bdevijve/STM32F1_28Outputs/README.md

# STM32F1_28Outputs
Carte domotique de Gaël - STM32F103VET6 - 28 sorties NPN 5-24V
