bdevijve/STM32F1_28Outputs/HW/Ressources/étiquette.pdf

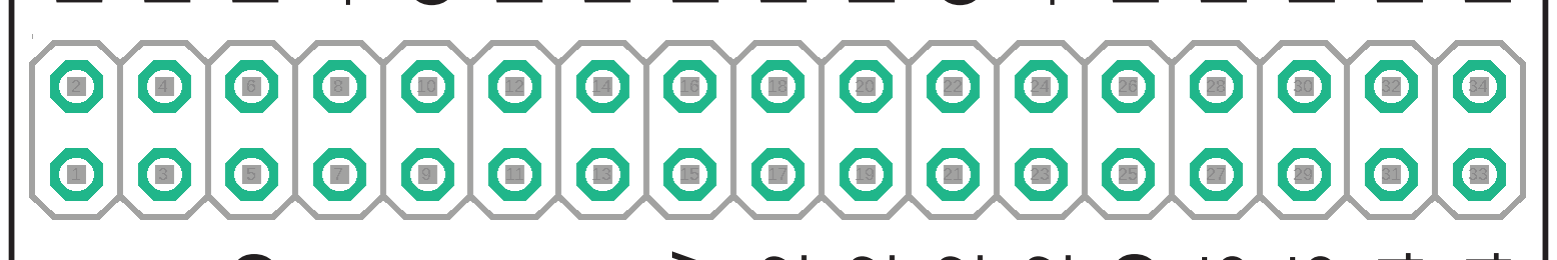
[picture p1: figure]

1 | 2 | 3 | 4 | 5 | 6 | 7 | 8 | 9 | 10 11 12 13 14 15 16 17 18 19 20 21 22 23 24 25 26 27 28

## COMMUN +

## 28 SORTIES PNP - COMMUTATION PAR LE (-)

GND | + | ETHERNET

## Alimentation: 5V - 24V DC Maximum 5A

# MODULE DE PILOTAGE DE RELAIS - 28 SORTIES

BOOT0

PB7 - SDA1
PB6 - SCL1

+3.3V
GND

PD7 - CK2
PD5 - RX2
PD6 - TX2

PD4 - RTS2

PD3 - CTS2

GND

+3.3V

PA8 - CK1
PA9 - RX1

PA10 - TX1

PA12 - RTS1

PA11 - CTS1

BP2 -BOOT1

PD5 - SMBA1
GND

PA4 - NSS1

PA5 - SCK1
PA7 - MOSI1

PA6 - MISO1

+3.3V
PB12 - NSS2
PB13 - SCK2

PB15 - MOSI2

PB14 - MISO2
GND

PC12 - RX5

PD2 - TX5

PC10 - RX4

PC11 - TX4

## STM32F103VET6
