bdevijve/STM32F1_28Outputs/HW/Image 1.png

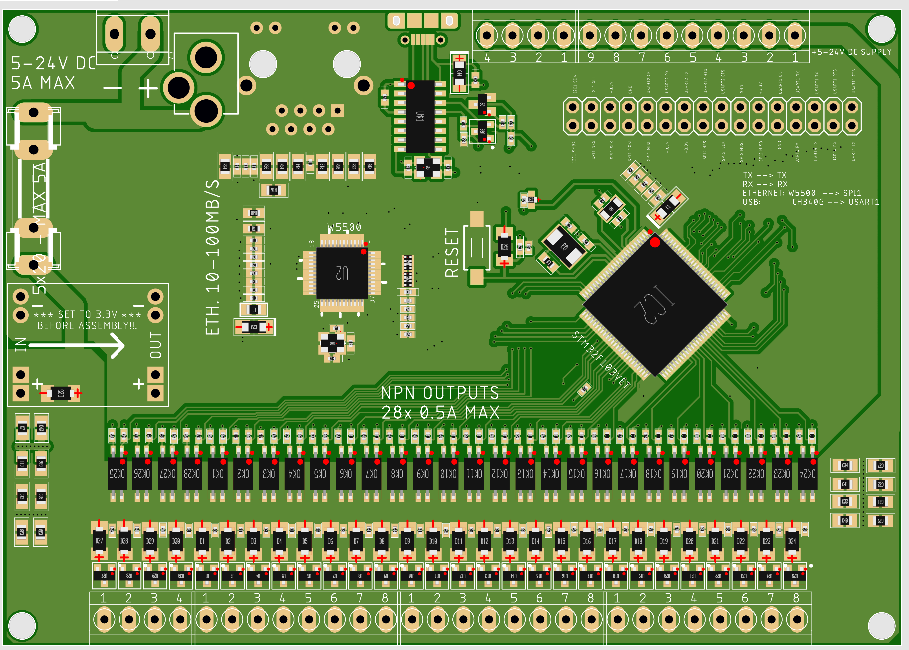
HW/Image 1.png
