bdevijve/STM32F1_28Outputs/HW/Image 2.png

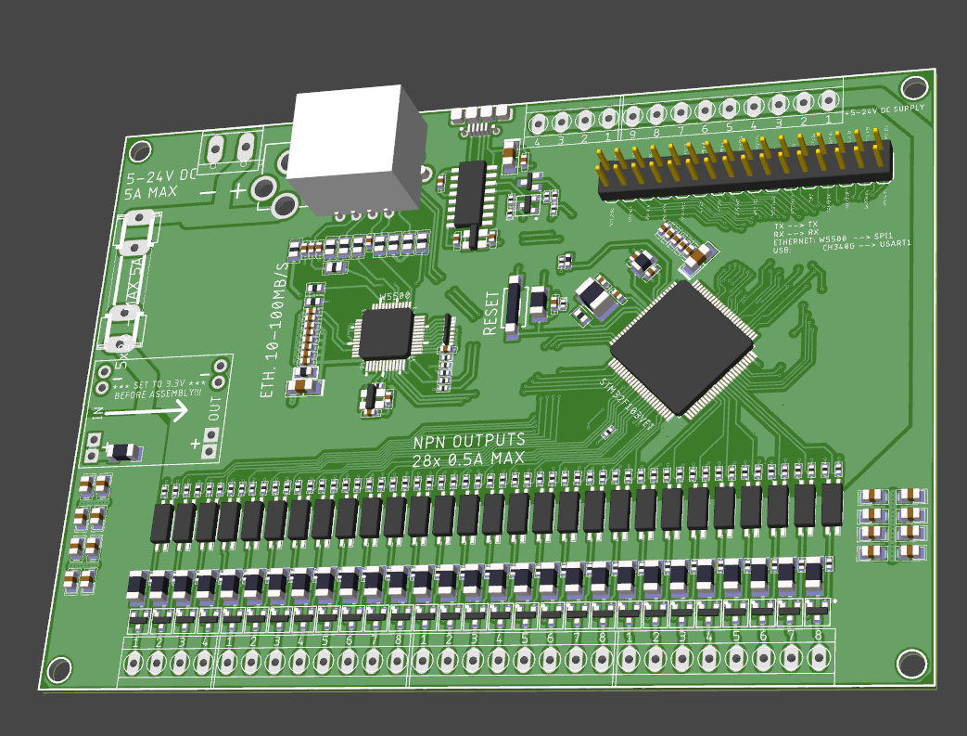
HW/Image 2.png
