bdevijve/STM32F1_28Outputs/HW/Ressources/boitier rail DIN.png

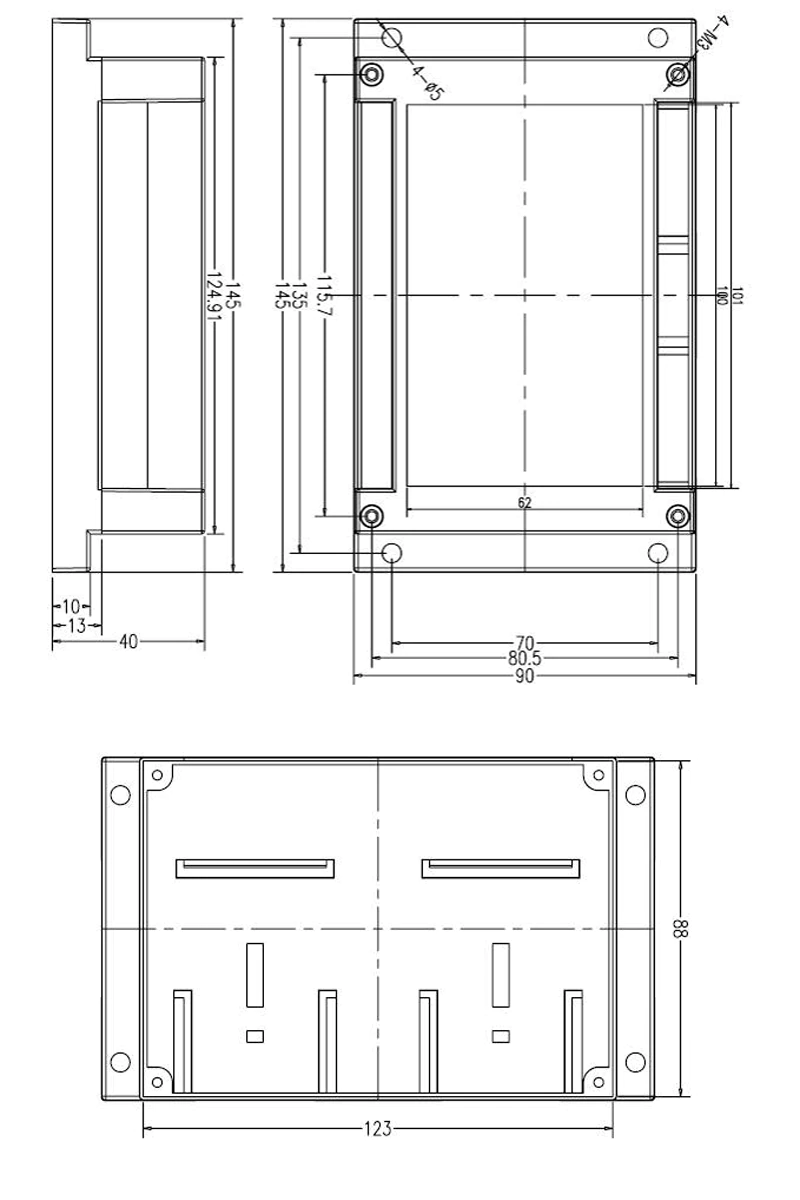
HW/Ressources/boitier rail DIN.png
