bdevijve/STM32F1_28Outputs/HW/Ressources/Capture d'écran 2020-09-11 17.22.37.png

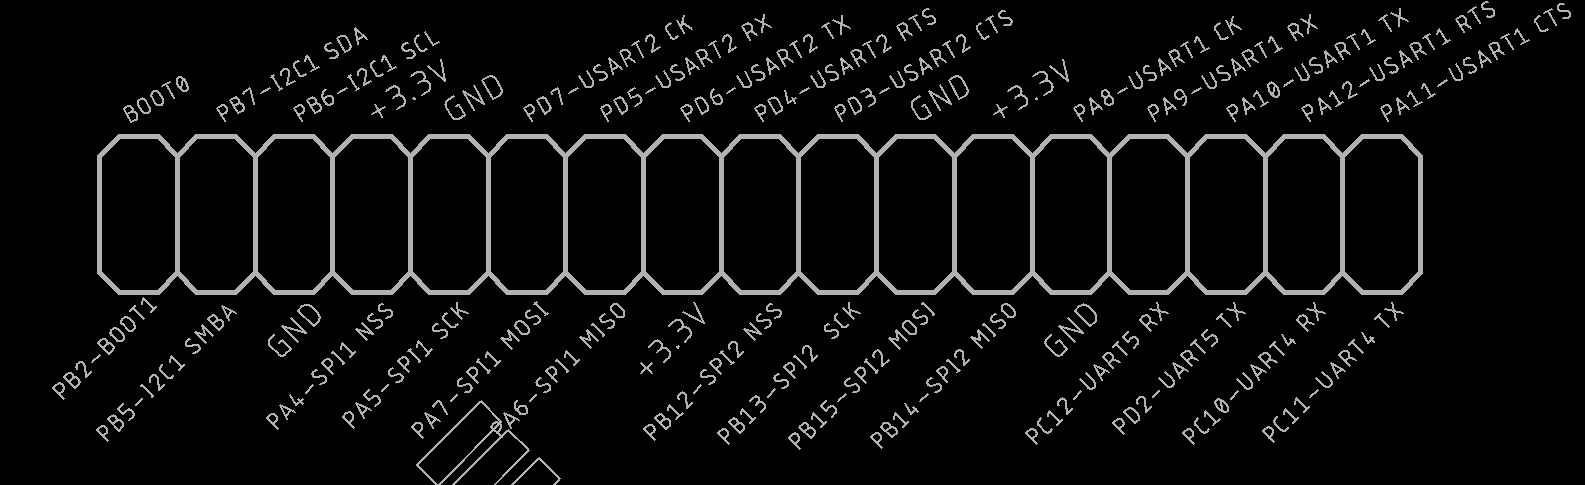
HW/Ressources/Capture d'écran 2020-09-11 17.22.37.png
