bdevijve/STM32F1_28Outputs/HW/Ressources/Capture d'écran.png

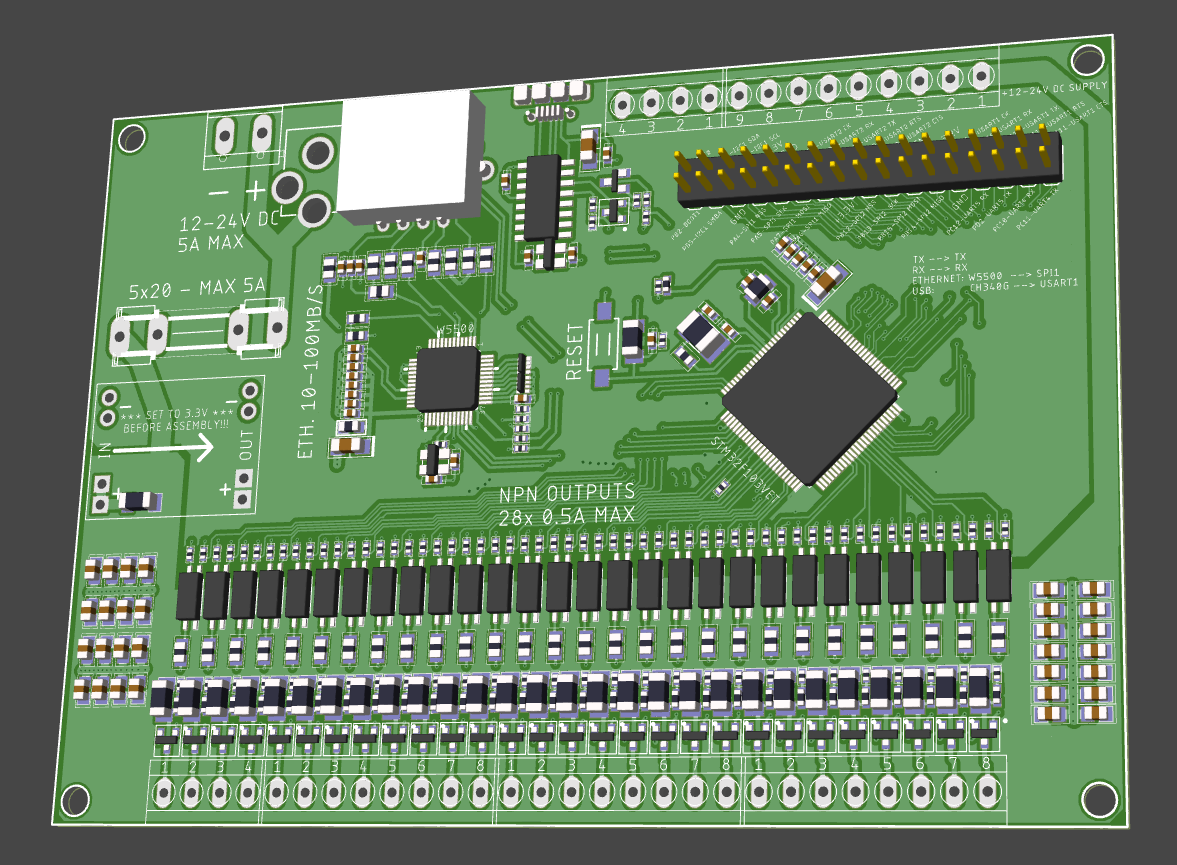
HW/Ressources/Capture d'écran.png
