bdevijve/STM32F1_28Outputs/HW/Ressources/microcontroller-relay-driver-interface.jpg

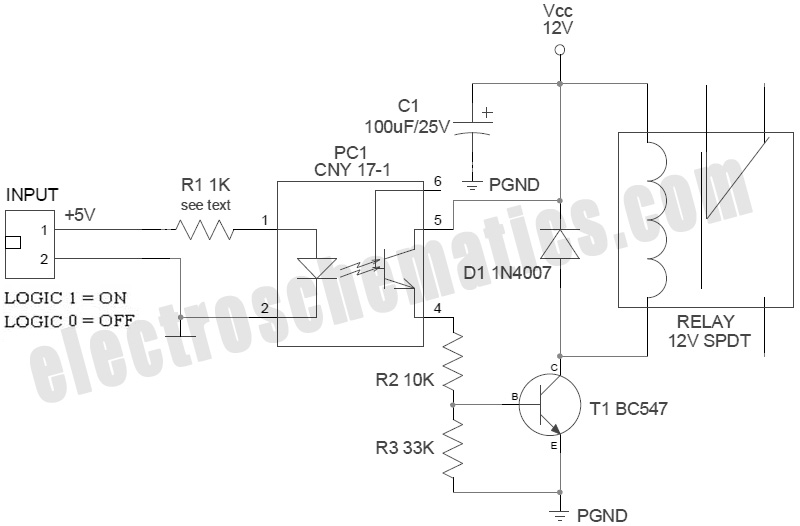
HW/Ressources/microcontroller-relay-driver-interface.jpg
