bdevijve/STM32F1_28Outputs/HW/Ressources/CAMOutputs/BOM.xlsx

COMMENT | DESIGNATOR | FOOTPRINT | Device | Description | PART NUMBER
 | LED1 | CHIP-LED0603 |  | LED | C2286 (https://lcsc.com/product-detail/Light-Emitting-Diodes-LED_Hubei-KENTO-Elec-KT-0603R_C2286.html/?href=jlc-SMT)
 | LED2 | SML0603 |  | LED | C2286
 | LED3 | SML0603 |  | LED | C2286
 | LED4 | SML0603 |  | LED | C2286
 | LED5 | SML0603 |  | LED | C2286
 | LED6 | SML0603 |  | LED | C2286
 | LED7 | SML0603 |  | LED | C2286
 | LED8 | SML0603 |  | LED | C2286
 | LED9 | SML0603 |  | LED | C2286
 | LED10 | SML0603 |  | LED | C2286
 | LED11 | SML0603 |  | LED | C2286
 | LED12 | SML0603 |  | LED | C2286
 | LED13 | SML0603 |  | LED | C2286
 | LED14 | SML0603 |  | LED | C2286
 | LED15 | SML0603 |  | LED | C2286
 | LED16 | SML0603 |  | LED | C2286
 | LED17 | SML0603 |  | LED | C2286
 | LED18 | SML0603 |  | LED | C2286
 | LED19 | SML0603 |  | LED | C2286
 | LED20 | SML0603 |  | LED | C2286
 | LED21 | SML0603 |  | LED | C2286
 | LED22 | SML0603 |  | LED | C2286
 | LED23 | SML0603 |  | LED | C2286
 | LED24 | SML0603 |  | LED | C2286
 | LED25 | SML0603 |  | LED | C2286
 | LED26 | SML0603 |  | LED | C2286
 | LED27 | SML0603 |  | LED | C2286
 | LED28 | SML0603 |  | LED | C2286
 | LED29 | SML0603 |  | LED | C2286 (https://lcsc.com/product-detail/Light-Emitting-Diodes-LED_Hubei-KENTO-Elec-KT-0603R_C2286.html/?href=jlc-SMT)
100K | R9 | R0402 |  | RESISTOR, European symbol | C25741
100K | R11 | R0402 |  | RESISTOR, European symbol | C25741
100K | R42 | R0402 |  | RESISTOR, European symbol | C25741
100K | R51 | R0402 |  | RESISTOR, European symbol | C25741
100K | R61 | R0402 |  | RESISTOR, European symbol | C25741
100K | R70 | R0402 |  | RESISTOR, European symbol | C25741
100K | R95 | R0402 |  | RESISTOR, European symbol | C25741
100K | R96 | R0402 |  | RESISTOR, European symbol | C25741
100K | R97 | R0402 |  | RESISTOR, European symbol | C25741
100K | R98 | R0402 |  | RESISTOR, European symbol | C25741
100K | R99 | R0402 |  | RESISTOR, European symbol | C25741
100K | R100 | R0402 |  | RESISTOR, European symbol | C25741
100K | R101 | R0402 |  | RESISTOR, European symbol | C25741
100K | R102 | R0402 |  | RESISTOR, European symbol | C25741
100K | R103 | R0402 |  | RESISTOR, European symbol | C25741
100K | R104 | R0402 |  | RESISTOR, European symbol | C25741
100K | R105 | R0402 |  | RESISTOR, European symbol | C25741
100K | R106 | R0402 |  | RESISTOR, European symbol | C25741
100K | R107 | R0402 |  | RESISTOR, European symbol | C25741
100K | R108 | R0402 |  | RESISTOR, European symbol | C25741
100K | R109 | R0402 |  | RESISTOR, European symbol | C25741
100K | R110 | R0402 |  | RESISTOR, European symbol | C25741
100K | R111 | R0402 |  | RESISTOR, European symbol | C25741
100K | R112 | R0402 |  | RESISTOR, European symbol | C25741
100K | R113 | R0402 |  | RESISTOR, European symbol | C25741
100K | R114 | R0402 |  | RESISTOR, European symbol | C25741
100K | R115 | R0402 |  | RESISTOR, European symbol | C25741
100K | R116 | R0402 |  | RESISTOR, European symbol | C25741
100K | R117 | R0402 |  | RESISTOR, European symbol | C25741
100K | R118 | R0402 |  | RESISTOR, European symbol | C25741
100nF | C3 | C0402 |  | CAPACITOR, European symbol | C1525 (https://lcsc.com/product-detail/Multilayer-Ceramic-Capacitors-MLCC-SMD-SMT_SAMSUNG_CL05B104KO5NNNC_100nF-104-10-16V_C1525.html/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)
100nF | C4 | C0402 |  | CAPACITOR, European symbol | C1525 (https://lcsc.com/product-detail/Multilayer-Ceramic-Capacitors-MLCC-SMD-SMT_SAMSUNG_CL05B104KO5NNNC_100nF-104-10-16V_C1525.html/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)
100nF | C5 | C0402 |  | CAPACITOR, European symbol | C1525
100nF | C6 | C0402 |  | CAPACITOR, European symbol | C1525
100nF | C8 | C0402 |  | CAPACITOR, European symbol | C1525
100nF | C15 | C0402 |  | CAPACITOR, European symbol | C1525
100nF | C20 | C0402 |  | CAPACITOR, European symbol | C1525
100nF | C22 | C0402 |  | CAPACITOR, European symbol | C1525
100nF | C24 | C0402 |  | CAPACITOR, European symbol | C1525
100nF | C25 | C0402 |  | CAPACITOR, European symbol | C1525
100nF | C26 | C0402 |  | CAPACITOR, European symbol | C1525
100nF | C27 | C0402 |  | CAPACITOR, European symbol | C1525
100pF | C45 | C0402 |  | CAPACITOR, European symbol | C1546 (https://lcsc.com/product-detail/Multilayer-Ceramic-Capacitors-MLCC-SMD-SMT_100pF-101-5-50V_C1546.html/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)
100pF | C46 | C0402 |  | CAPACITOR, European symbol | C1546 (https://lcsc.com/product-detail/Multilayer-Ceramic-Capacitors-MLCC-SMD-SMT_100pF-101-5-50V_C1546.html/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)
10K | R4 | R0402 |  | RESISTOR, European symbol | C25744 (https://lcsc.com/product-detail/Multilayer-Ceramic-Capacitors-MLCC-SMD-SMT_SAMSUNG_CL21B474KBFNNNE_470nF-474-10-50V_C13967.html/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)
10K | R6 | R0402 |  | RESISTOR, European symbol | C25744 (https://lcsc.com/product-detail/Multilayer-Ceramic-Capacitors-MLCC-SMD-SMT_SAMSUNG_CL21B474KBFNNNE_470nF-474-10-50V_C13967.html/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)
10K | R8 | R0402 |  | RESISTOR, European symbol | C25744
10K | R29 | R0402 |  | RESISTOR, European symbol | C25744
10K | R31 | R0402 |  | RESISTOR, European symbol | C25744
10K | RN1 | 4X0402ARV341 |  | Array Chip Resistor | C25725 (https://lcsc.com/product-detail/Resistor-Networks-Arrays_Uniroyal-Elec-4D02WGJ0103TCE_C25725.html/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)
10K | RN2 | 4X0402ARV341 |  | Array Chip Resistor | C25725 (https://lcsc.com/product-detail/Resistor-Networks-Arrays_Uniroyal-Elec-4D02WGJ0103TCE_C25725.html/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)
10nF | C9 | C0402 |  | CAPACITOR, European symbol | C15195 (https://lcsc.com/product-detail/Multilayer-Ceramic-Capacitors-MLCC-SMD-SMT_SAMSUNG_CL05B103KB5NNNC_10nF-103-10-50V_C15195.html/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)
10nF | C13 | C0402 |  | CAPACITOR, European symbol | C15195 (https://lcsc.com/product-detail/Multilayer-Ceramic-Capacitors-MLCC-SMD-SMT_SAMSUNG_CL05B103KB5NNNC_10nF-103-10-50V_C15195.html/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)
10pF | C17 | C0402 |  | CAPACITOR, European symbol | C32949 (https://lcsc.com/product-detail/Multilayer-Ceramic-Capacitors-MLCC-SMD-SMT_SAMSUNG_CL05C100JB5NNNC_10pF-100-5-50V_C32949.html/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)
10pF | C21 | C0402 |  | CAPACITOR, European symbol | C32949 (https://lcsc.com/product-detail/Multilayer-Ceramic-Capacitors-MLCC-SMD-SMT_SAMSUNG_CL05C100JB5NNNC_10pF-100-5-50V_C32949.html/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)
10uF/16V | C1 | C-3216(TANTAL) |  |  | C7171 (https://lcsc.com/product-detail/Tantalum-Capacitors_AVX_TAJA106K016RNJ_10uF-106-10-16V_C7171.html/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)
10uF/16V | C23 | C-3216(TANTAL) |  |  | C7171 (https://lcsc.com/product-detail/Tantalum-Capacitors_AVX_TAJA106K016RNJ_10uF-106-10-16V_C7171.html/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)
10uF/16V | C44 | C-3216(TANTAL) |  |  | C7171 (https://lcsc.com/product-detail/Tantalum-Capacitors_AVX_TAJA106K016RNJ_10uF-106-10-16V_C7171.html/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)
12MHz | Q5 | 3.2X2.5_KX-7 |  | Quartz Crystals (MHz) SMD: | C9002 (https://lcsc.com/product-detail/SMD-Crystal-Resonators_Yangxing-Tech-X322512MSB4SI_C9002.html/?href=jlc-SMT)
18pF | C18 | C0402 |  | CAPACITOR, European symbol | C1549 (https://lcsc.com/product-detail/Multilayer-Ceramic-Capacitors-MLCC-SMD-SMT_18pF-180-5-50V_C1549.html/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)
18pF | C19 | C0402 |  | CAPACITOR, European symbol | C1549 (https://lcsc.com/product-detail/Multilayer-Ceramic-Capacitors-MLCC-SMD-SMT_18pF-180-5-50V_C1549.html/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)
1ÂµF | C28 | C0402 |  | CAPACITOR, European symbol | C52923 (https://lcsc.com/product-detail/Multilayer-Ceramic-Capacitors-MLCC-SMD-SMT_SAMSUNG_CL05A105KA5NQNC_1uF-105-10-25V_C52923.html/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)
1K | R13 | R0402 |  | RESISTOR, European symbol | C11702 (https://lcsc.com/product-detail/Chip-Resistor-Surface-Mount_Uniroyal-Elec-0402WGF1001TCE_C11702.html/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)
1K | R18 | R0402 |  | RESISTOR, European symbol | C11702 (https://lcsc.com/product-detail/Chip-Resistor-Surface-Mount_Uniroyal-Elec-0402WGF1001TCE_C11702.html/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)
1K | R23 | R0402 |  | RESISTOR, European symbol | C11702
1M | R52 | R0402 |  | RESISTOR, European symbol | C26083 (https://lcsc.com/product-detail/Chip-Resistor-Surface-Mount_Uniroyal-Elec-0402WGF1004TCE_C26083.html/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)
20pF | C2 | C0402 |  | CAPACITOR, European symbol | C1554 (https://lcsc.com/product-detail/Multilayer-Ceramic-Capacitors-MLCC-SMD-SMT_20pF-200-5-50V_C1554.html/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)
20pF | C29 | C0402 |  | CAPACITOR, European symbol | C1554 (https://lcsc.com/product-detail/Multilayer-Ceramic-Capacitors-MLCC-SMD-SMT_20pF-200-5-50V_C1554.html/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)
22nF | C14 | C0402 |  | CAPACITOR, European symbol | C1532 (https://lcsc.com/product-detail/Multilayer-Ceramic-Capacitors-MLCC-SMD-SMT_22nF-223-10-50V_C1532.html/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)
22pF | C47 | C0402 |  | CAPACITOR, European symbol | C1555 (https://lcsc.com/product-detail/Multilayer-Ceramic-Capacitors-MLCC-SMD-SMT_22pF-220-5-50V_C1555.html/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)
22pF | C48 | C0402 |  | CAPACITOR, European symbol | C1555 (https://lcsc.com/product-detail/Multilayer-Ceramic-Capacitors-MLCC-SMD-SMT_22pF-220-5-50V_C1555.html/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)
25MHz | Q1 | 3.2X2.5_KX-7 |  | Quartz Crystals (MHz) SMD: | C9006 (https://lcsc.com/product-detail/SMD-Crystal-Resonators_Yangxing-Tech-X322525MOB4SI_C9006.html/?href=jlc-SMT)
32.768KHz | Q4 | 3.2X1.5 |  | Tuning Fork Crystals (kHz) SMD: | C32346 (https://lcsc.com/product-detail/SMD-Crystal-Resonators_Seiko-Epson_Q13FC1350000400_Seiko-Epson-Q13FC1350000400_C32346.html/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)
330R | R26 | R0402 |  | RESISTOR, European symbol | C25104 (https://lcsc.com/product-detail/Chip-Resistor-Surface-Mount_Uniroyal-Elec-0402WGF3300TCE_C25104.html/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)
330R | R28 | R0402 |  | RESISTOR, European symbol | C25104 (https://lcsc.com/product-detail/Chip-Resistor-Surface-Mount_Uniroyal-Elec-0402WGF3300TCE_C25104.html/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)
33R | R10 | R0805 |  | RESISTOR, European symbol | C17634 (https://lcsc.com/product-detail/Chip-Resistor-Surface-Mount_Uniroyal-Elec-0805W8F330JT5E_C17634.html/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)
33R | R12 | R0805 |  | RESISTOR, European symbol | C17634 (https://lcsc.com/product-detail/Chip-Resistor-Surface-Mount_Uniroyal-Elec-0805W8F330JT5E_C17634.html/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)
33R | R14 | R0805 |  | RESISTOR, European symbol | C17634 (https://lcsc.com/product-detail/Chip-Resistor-Surface-Mount_Uniroyal-Elec-0805W8F330JT5E_C17634.html/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)
33R | R16 | R0805 |  | RESISTOR, European symbol | C17634 (https://lcsc.com/product-detail/Chip-Resistor-Surface-Mount_Uniroyal-Elec-0805W8F330JT5E_C17634.html/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)
390R | R3 | R0603 |  | RESISTOR, European symbol | C23151 (https://lcsc.com/product-detail/Chip-Resistor-Surface-Mount_Uniroyal-Elec-0603WAF3900T5E_C23151.html/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)
3K | R7 | R0805 |  | RESISTOR, European symbol | C17661
3K | R17 | R0805 |  | RESISTOR, European symbol | C17661
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
NPN BJT S9013 | U23 | SOT-23-3 |  | Library: MF_Discrete_Semiconductor | C6749
NPN BJT S9013 | U24 | SOT-23-3 |  | Library: MF_Discrete_Semiconductor | C6749
NPN BJT S9013 | U25 | SOT-23-3 |  | Library: MF_Discrete_Semiconductor | C6749
NPN BJT S9013 | U26 | SOT-23-3 |  | Library: MF_Discrete_Semiconductor | C6749
NPN BJT S9013 | U27 | SOT-23-3 |  | Library: MF_Discrete_Semiconductor | C6749
NPN BJT S9013 | U28 | SOT-23-3 |  | Library: MF_Discrete_Semiconductor | C6749
NPN BJT S9013 | U29 | SOT-23-3 |  | Library: MF_Discrete_Semiconductor | C6749
NPN BJT S9013 | U30 | SOT-23-3 |  | Library: MF_Discrete_Semiconductor | C6749
S9012 | Q2 | SOT23 |  | PNP TRANSISTOR | C8543 (https://lcsc.com/product-detail/Transistors-NPN-PNP_Changjiang-Electronics-Tech-CJ-S9012_C8543.html/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)
S9013 | U1 | SOT-23-3 |  | Library: MF_Discrete_Semiconductor | C6749 (https://lcsc.com/product-detail/Transistors-NPN-PNP_Changjiang-Electronics-Tech-CJ-S9013_C6749.html/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)
STM32F103VET | IC2 | LQFP100 |  | ARM 32-bit Cortexâ„¢-M3 CPU | C8308 (https://lcsc.com/product-detail/ST-Microelectronics_STMicroelectronics_STM32F103VET6_STM32F103VET6_C8308.html/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)
W5500 | U2 | W5500 |  |  | C32843 (https://lcsc.com/product-detail/Ethernet-ICs_WIZNET_W5500_W5500_C32843.html/?href=jlc-SMT)
