bdevijve/STM32F1_28Outputs/HW/Ressources/STM32 output card.brd

## EAGLE design HW/Ressources/STM32 output card.brd (2020-12-27)

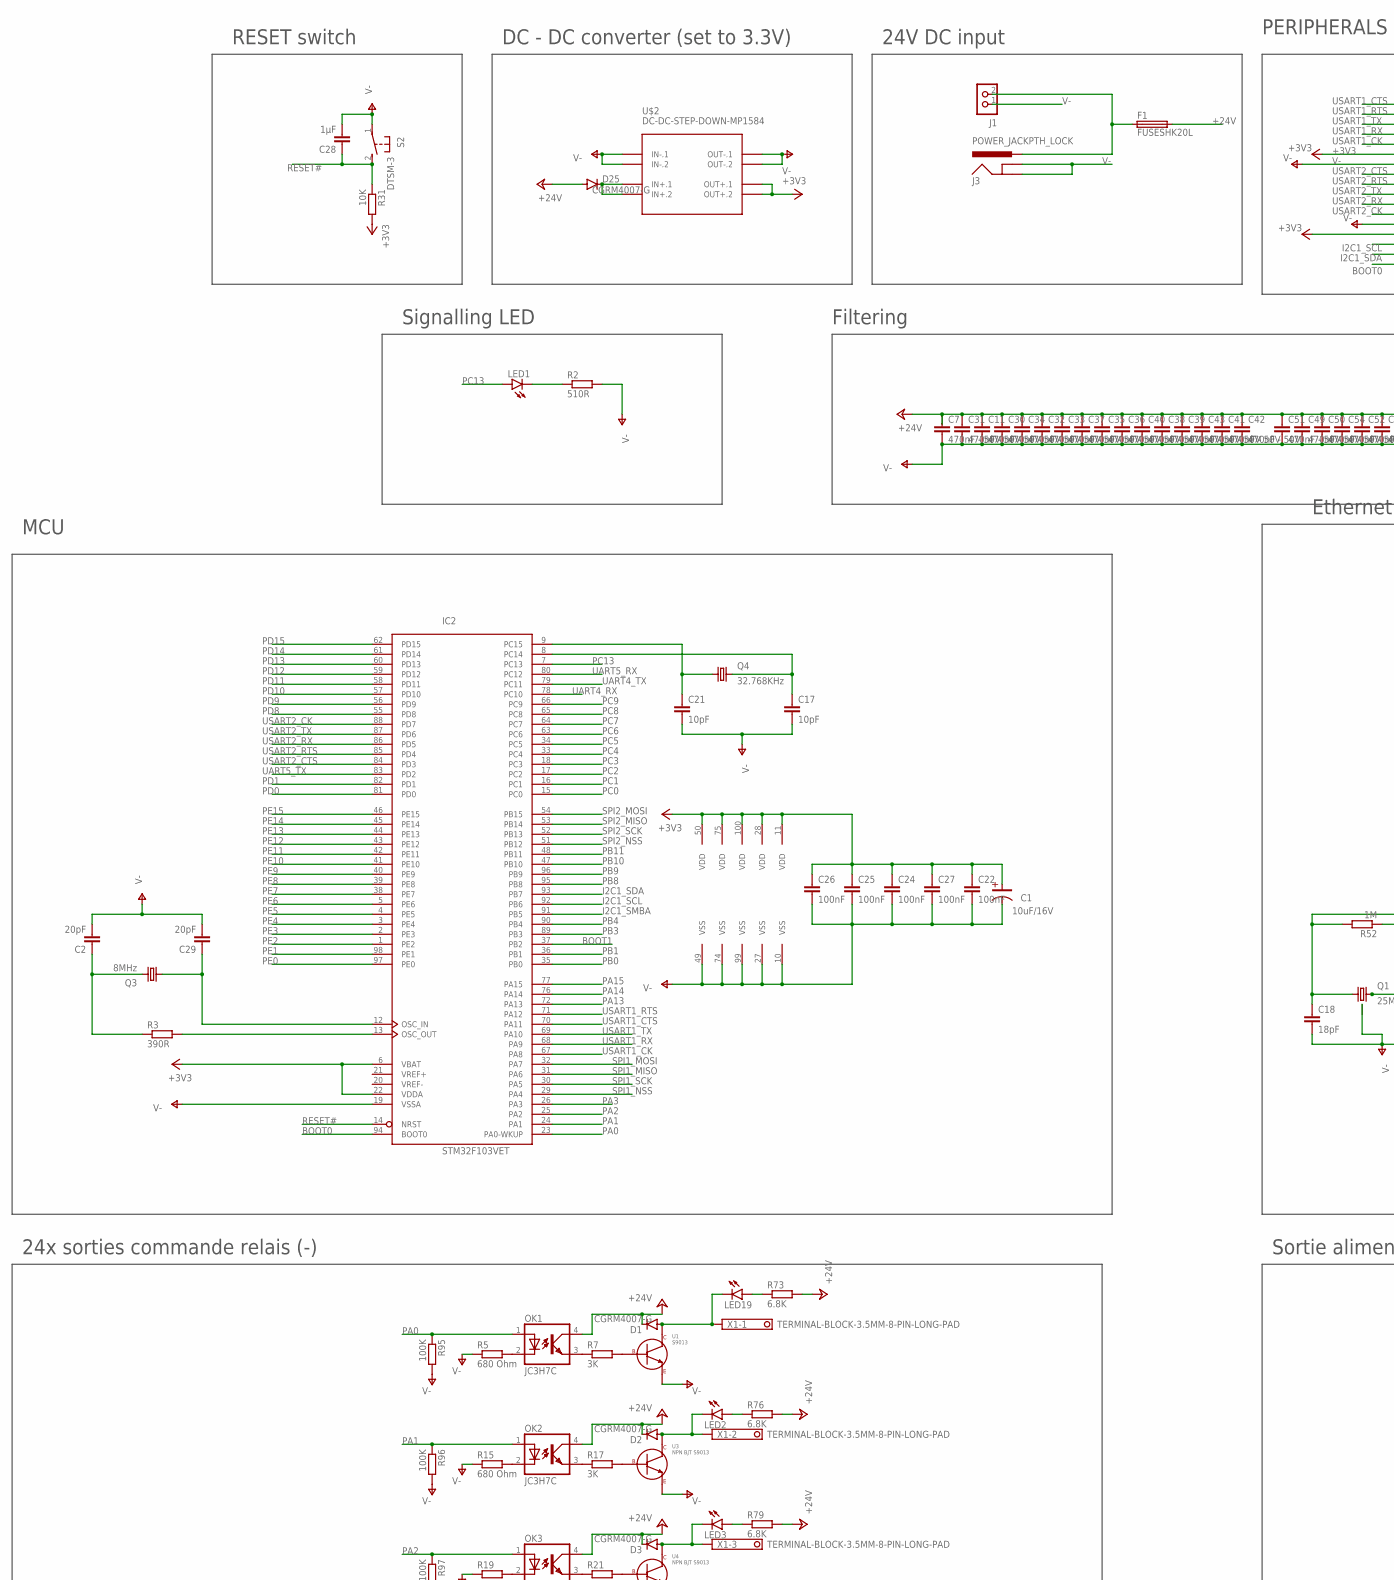
[picture p8: schematic STM32 output card.sch, part in row 1, column 1]

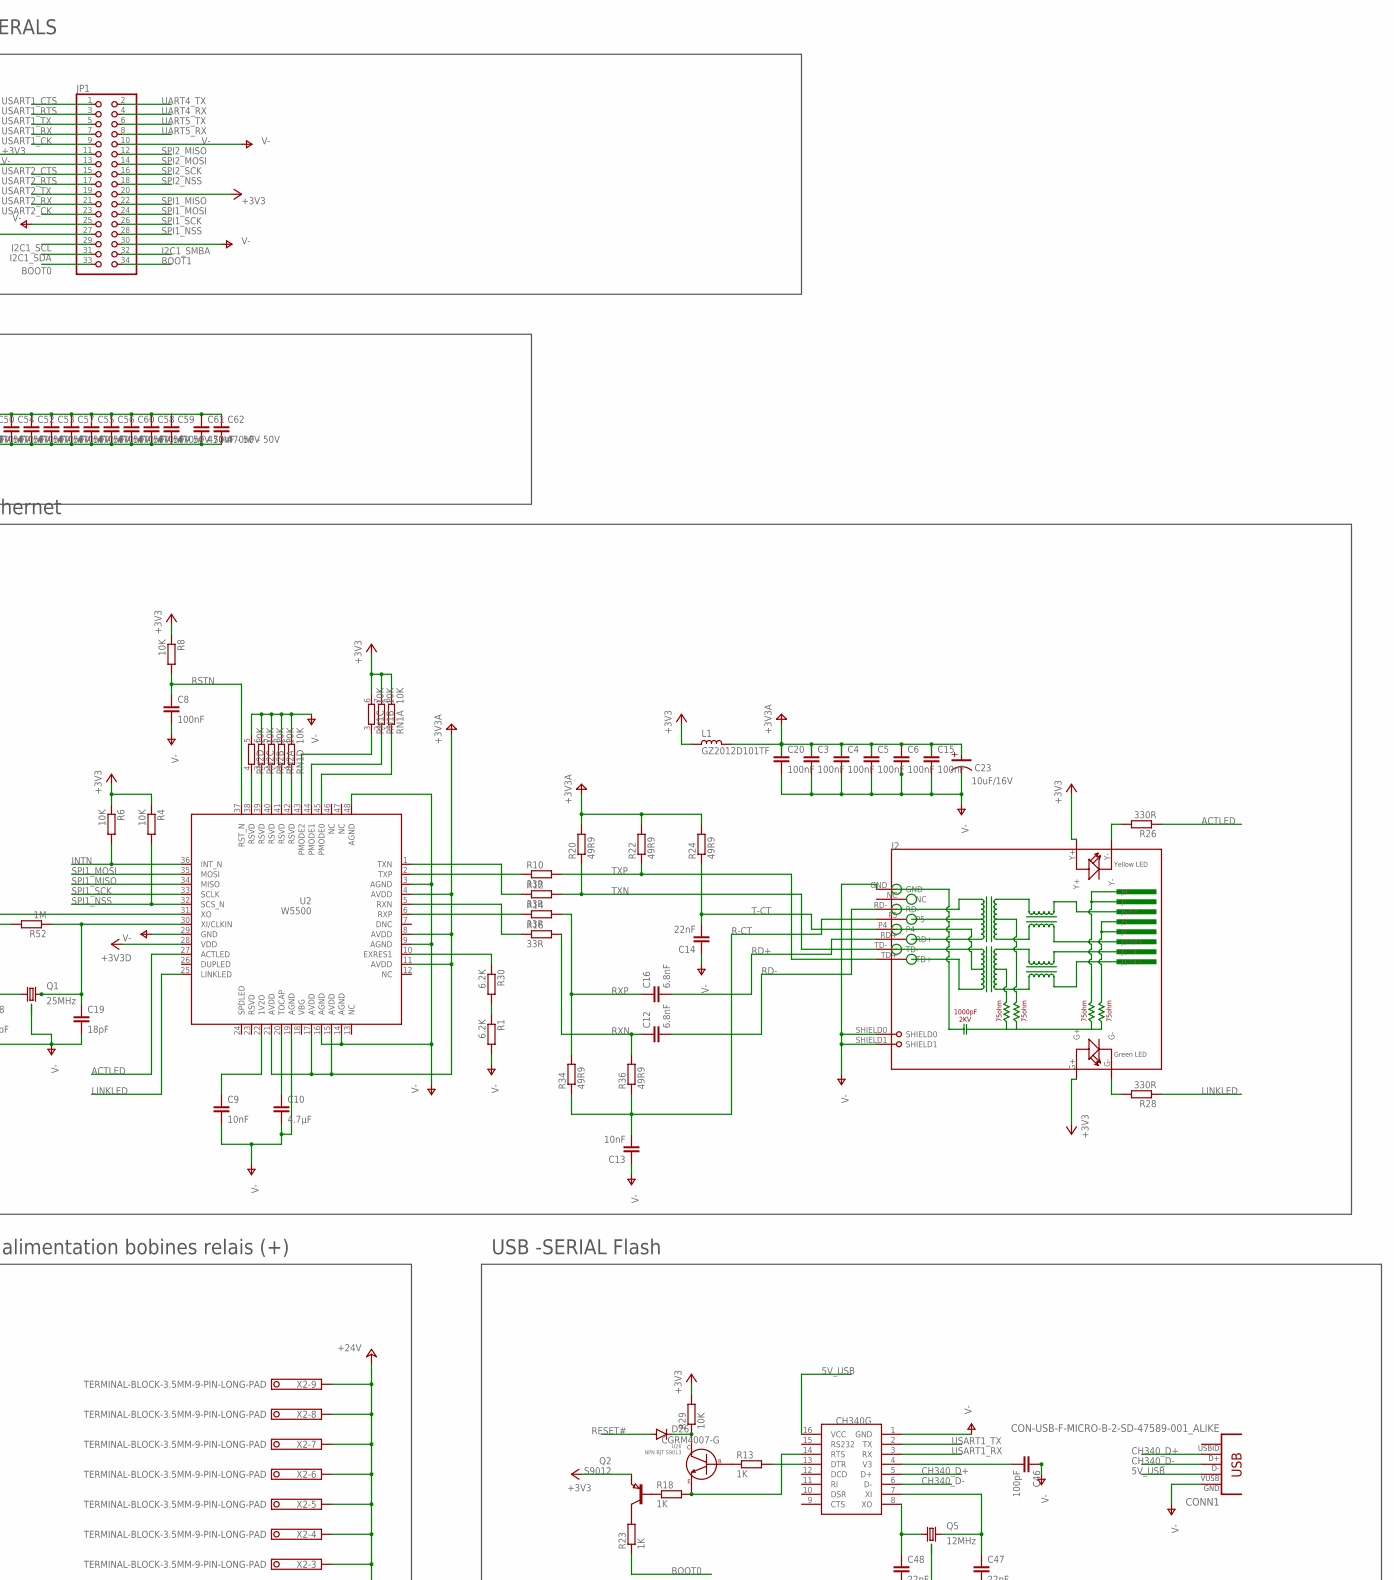
[picture p9: schematic STM32 output card.sch, part in row 1, column 2]

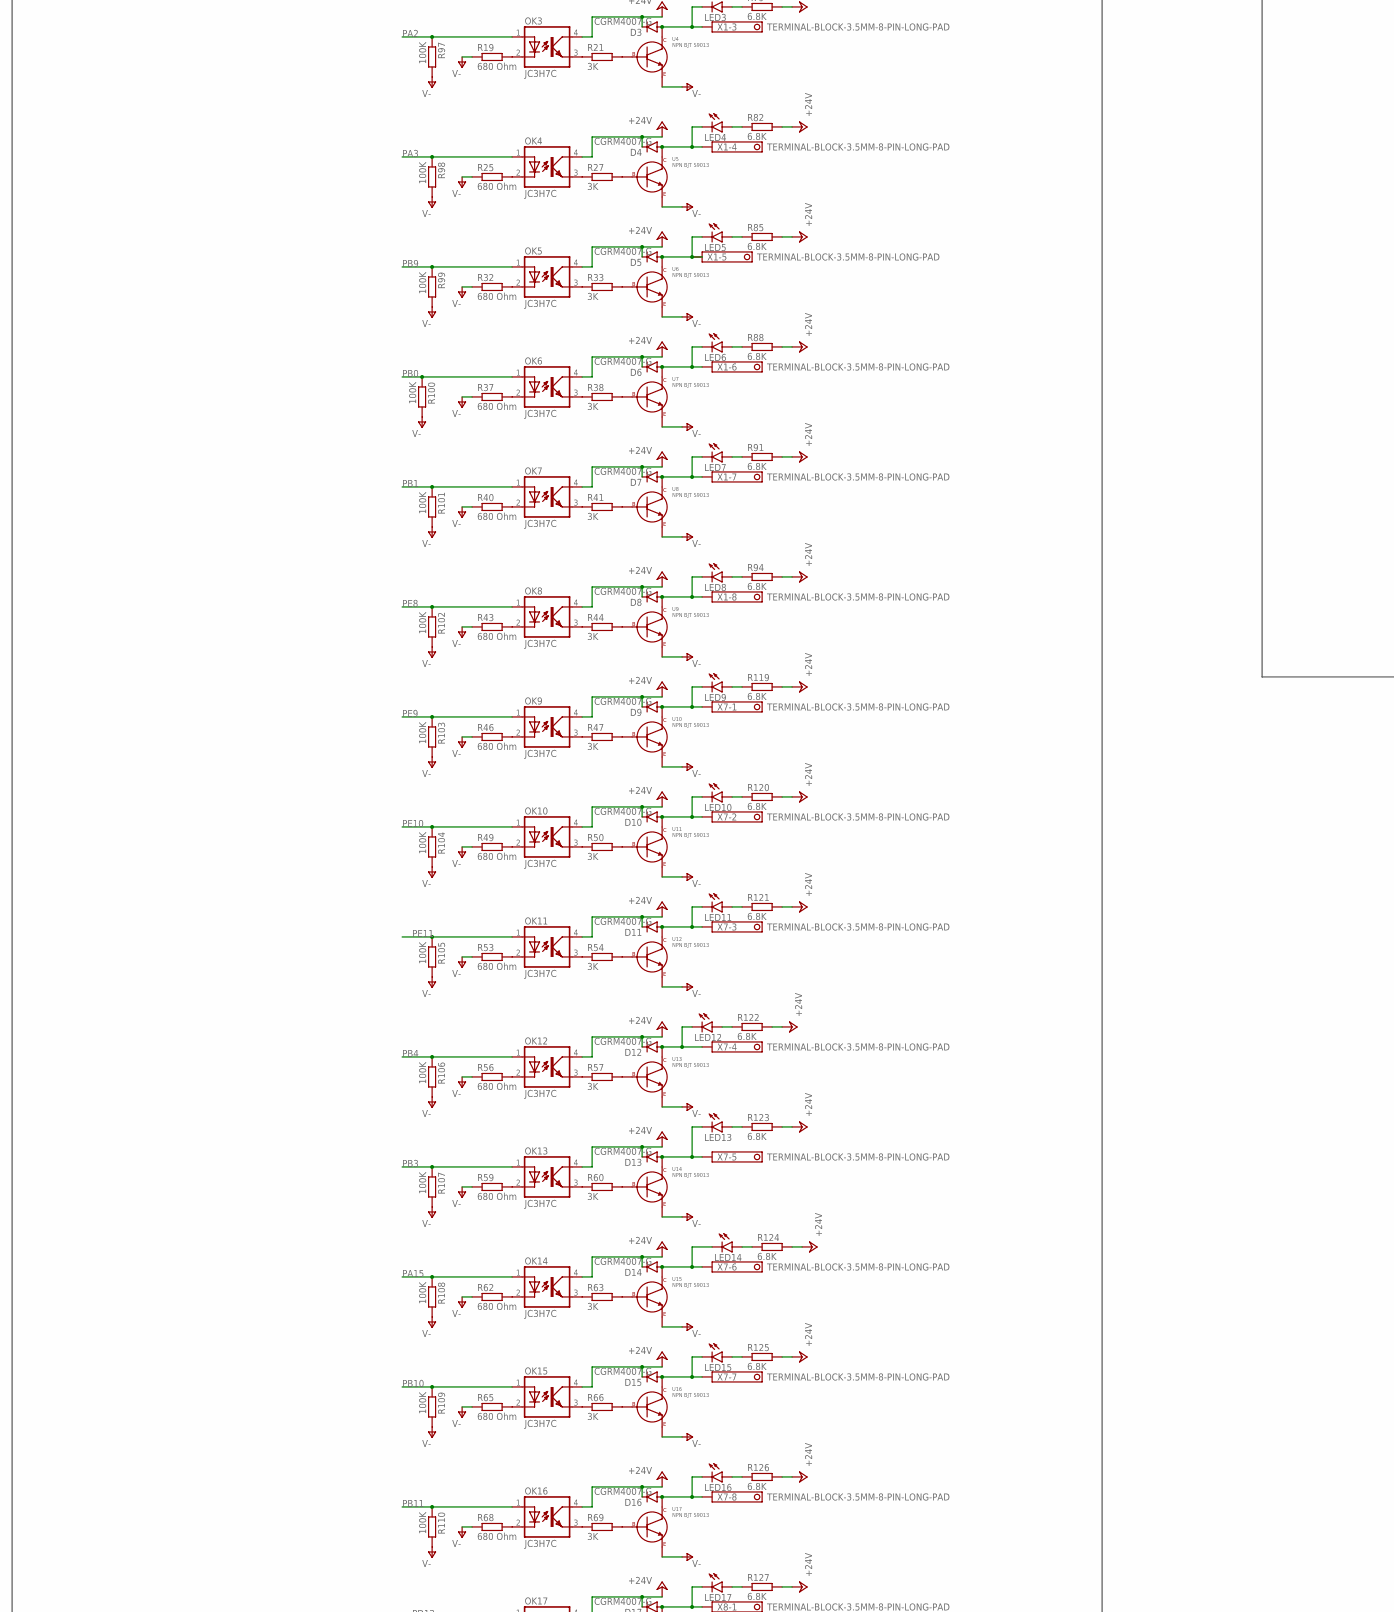
[picture p10: schematic STM32 output card.sch, part in row 2, column 1]

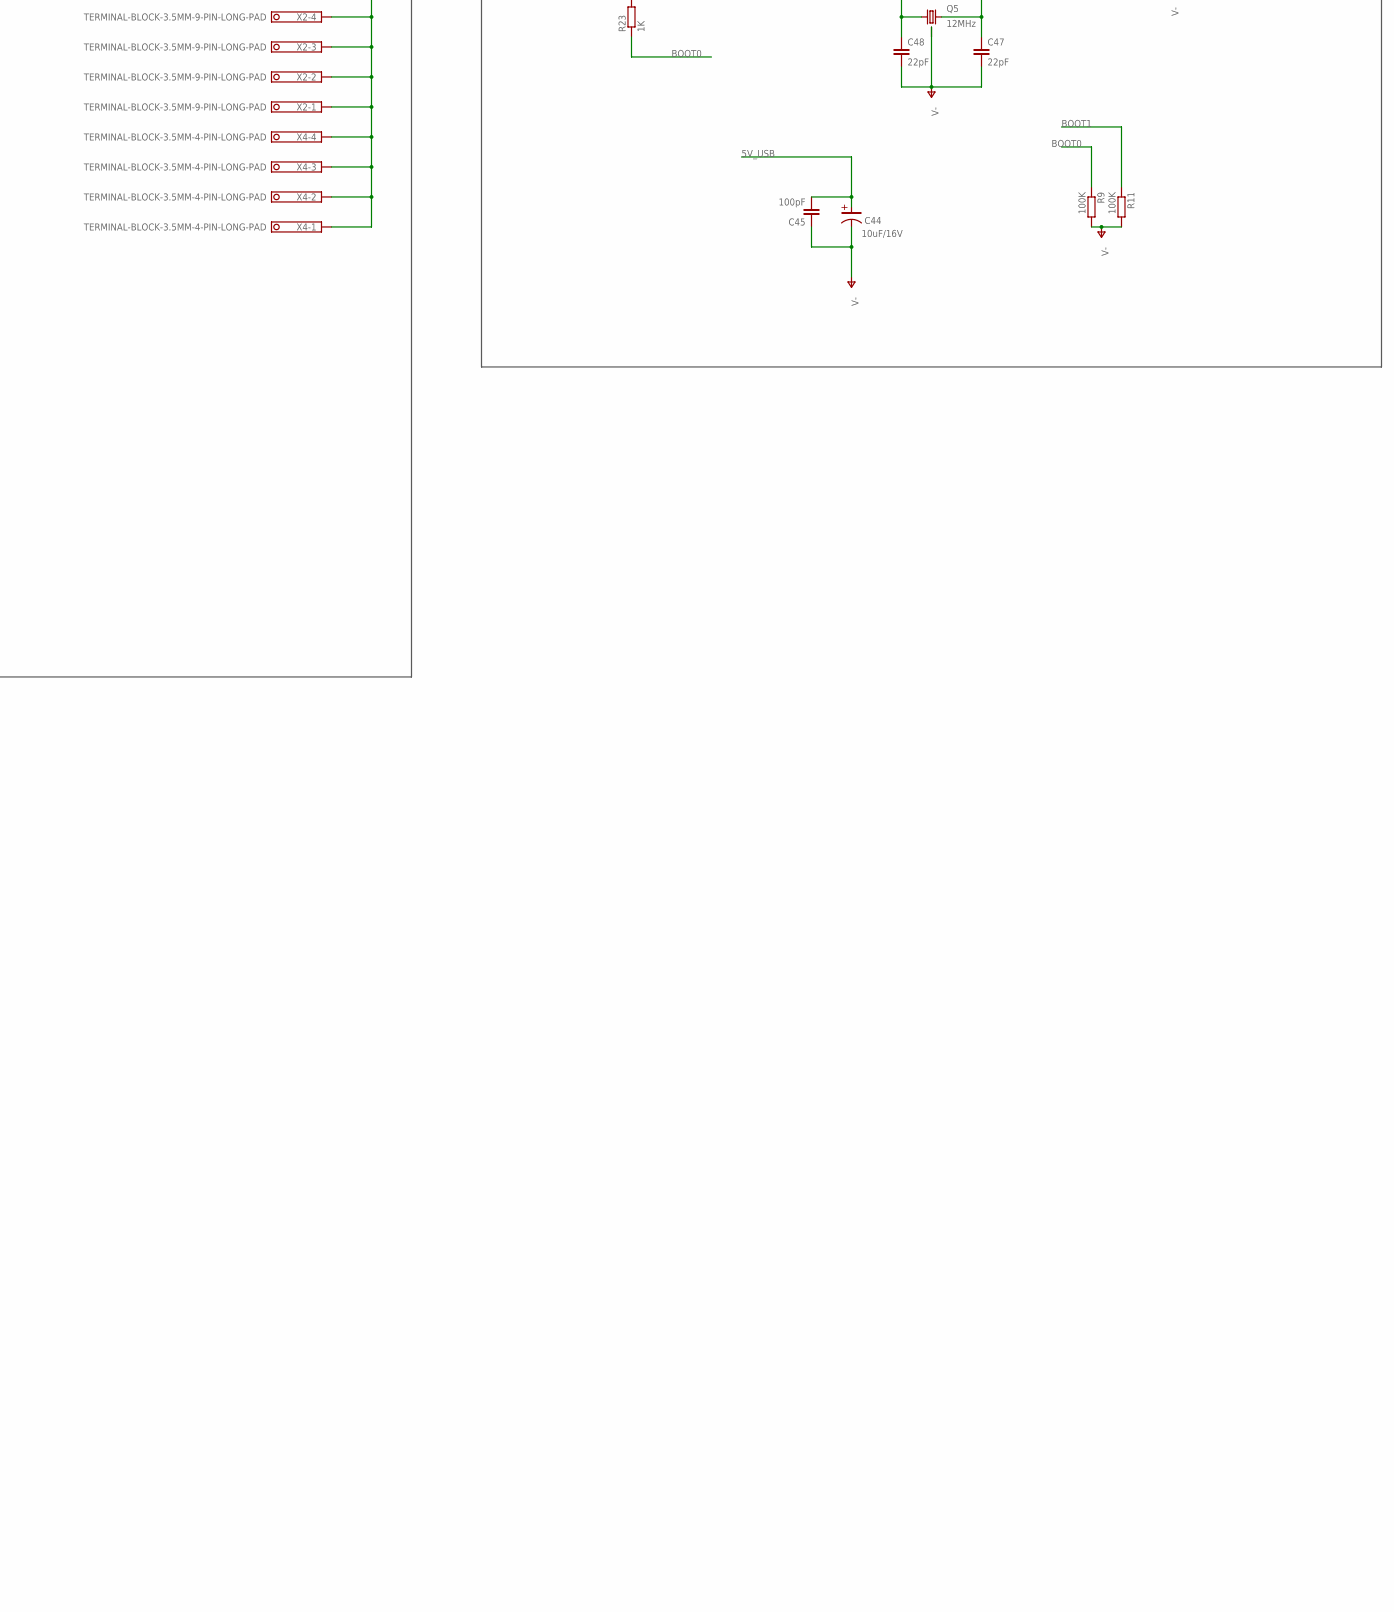
[picture p11: schematic STM32 output card.sch, part in row 2, column 2]

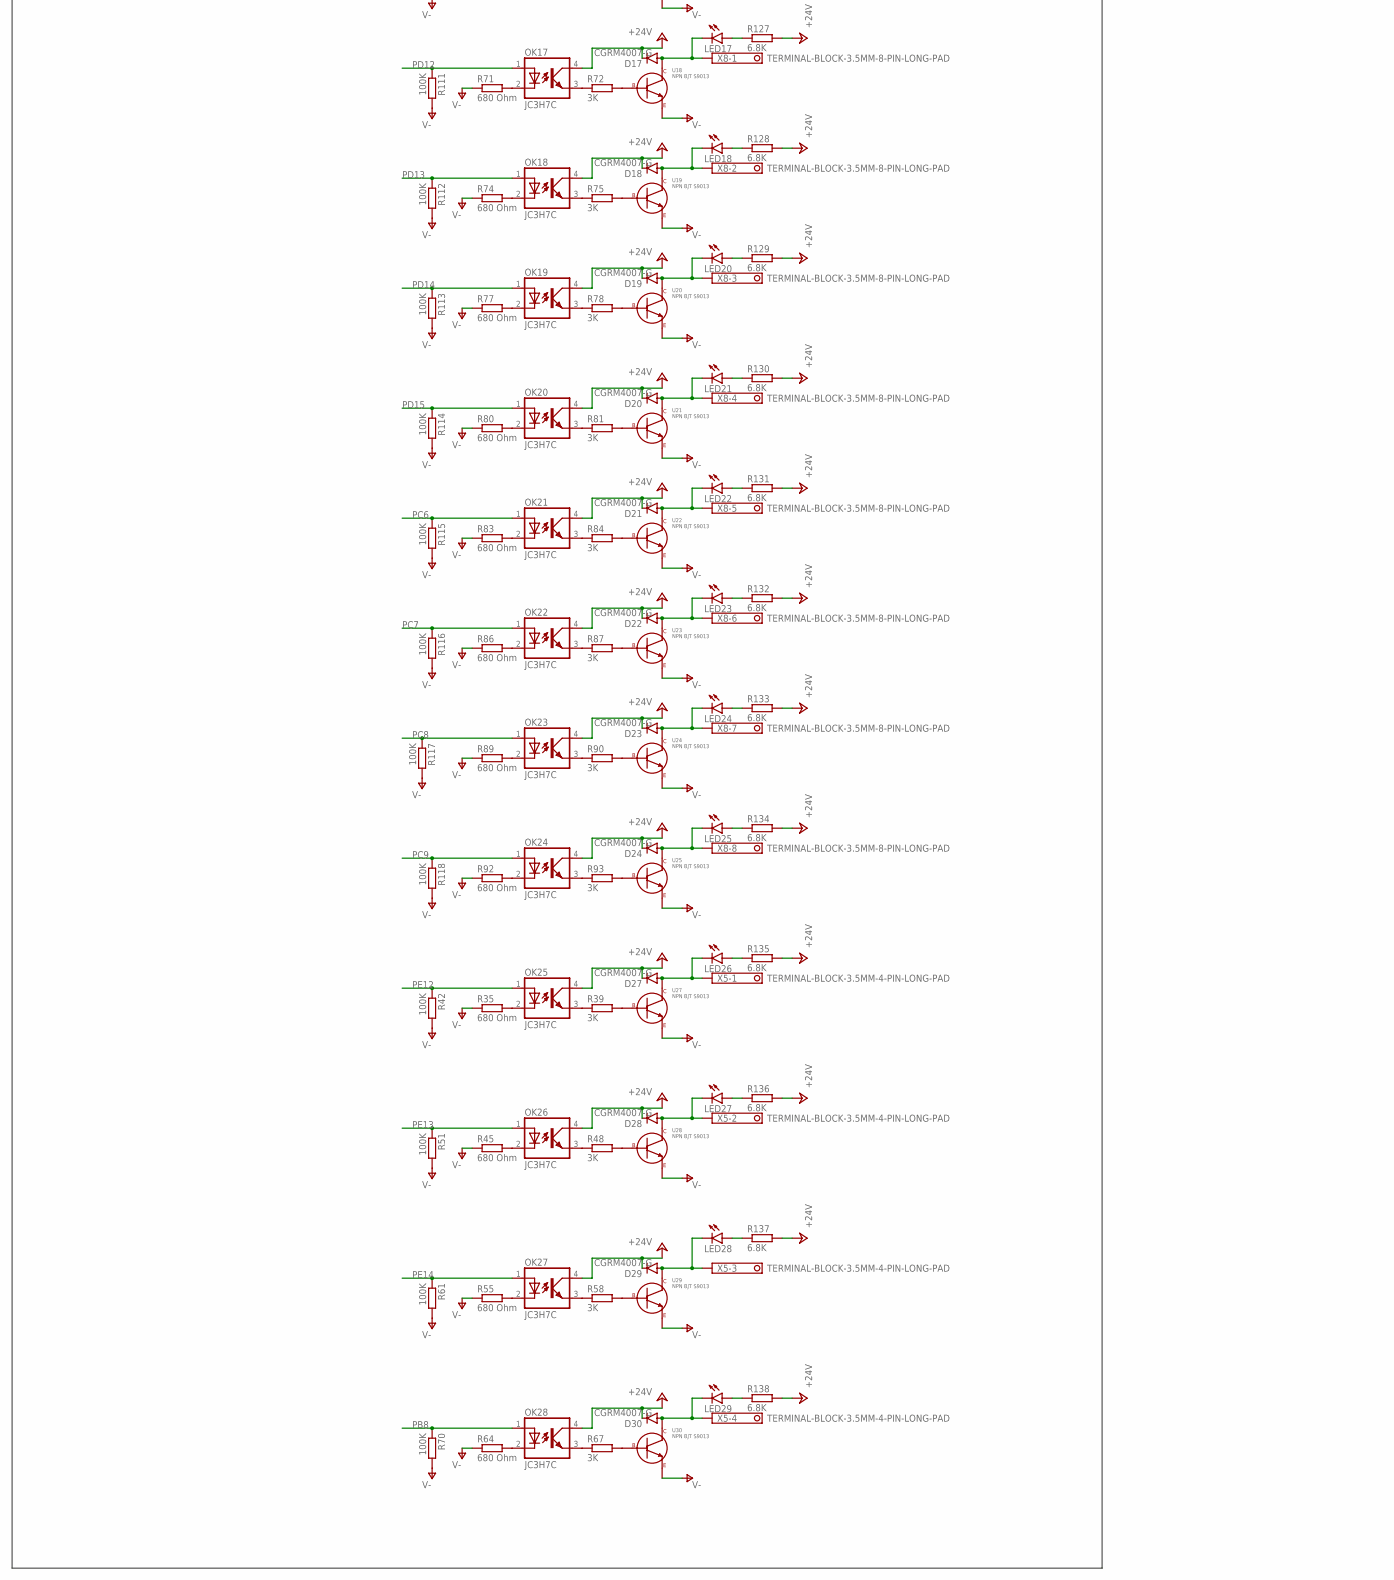
[picture p12: schematic STM32 output card.sch, part in row 3, column 1]

Parts:
C1, C23, C44: 10uF/16V; C-3216(TANTAL)
C2, C29: 20pF; C0402
C3, C4, C5, C6, C8, C15, C20, C22, C24, C25, C26, C27: 100nF; C0402
C7, C11, C30, C31, C32, C33, C34, C35, C36, C37, C38, C39, C40, C41, C42, C43, C49, C50, C51, C52, C53, C54, C55, C56, C57, C58, C59, C60, C61, C62: 470nF - 50V; C0805
C9, C13: 10nF; C0402
C10: 4.7µF; C0402
C12, C16: 6.8nF; C0402
C14: 22nF; C0402
C17, C21: 10pF; C0402
C18, C19: 18pF; C0402
C28: 1µF; C0402
C45, C46: 100pF; C0402
C47, C48: 22pF; C0402
CONN1: CON-USB-F-MICRO-B-2-SD-47589-001_ALIKE; CON_USB_MICRO-B-3
D1, D2, D3, D4, D5, D6, D7, D8, D9, D10, D11, D12, D13, D14, D15, D16, D17, D18, D19, D20, D21, D22, D23, D24, D25, D26, D27, D28, D29, D30: CGRM4007-G; SOD-123_MINI-SMA
F1: FUSESHK20L; SHK20L
IC2: STM32F103VET; LQFP100
J1: CON_TERMINAL_BLOCK_02-5MM; TERMINAL_BLOCK_2P_5
J2: RJ45-HR911105A-HR911105A; RJ45
J3: POWER_JACKPTH_LOCK; POWER_JACK_PTH_LOCK
JP1: PINHD-2X17; 2X17
L1: GZ2012D101TF; L0805
LED1: LEDCHIP-LED0603; CHIP-LED0603
LED2, LED3, LED4, LED5, LED6, LED7, LED8, LED9, LED10, LED11, LED12, LED13, LED14, LED15, LED16, LED17, LED18, LED19, LED20, LED21, LED22, LED23, LED24, LED25, LED26, LED27, LED28, LED29: LEDSML0603; SML0603
OK1, OK2, OK3, OK4, OK5, OK6, OK7, OK8, OK9, OK10, OK11, OK12, OK13, OK14, OK15, OK16, OK17, OK18, OK19, OK20, OK21, OK22, OK23, OK24, OK25, OK26, OK27, OK28: JC3H7C; MINI-FLAT-4
Q1: 25MHz; 3.2X2.5_KX-7
Q2: S9012; SOT23
Q3: 8MHz; 5.0X3.2_2
Q4: 32.768KHz; 3.2X1.5
Q5: 12MHz; 3.2X2.5_KX-7
R1, R30: 6.2K; R0603
R2: 510R; R0402
R3: 390R; R0603
R4, R6, R8, R29, R31: 10K; R0402
R5, R15, R19, R25, R32, R35, R37, R40, R43, R45, R46, R49, R53, R55, R56, R59, R62, R64, R65, R68, R71, R74, R77, R80, R83, R86, R89, R92: 680 Ohm; R0402
R7, R17, R21, R27, R33, R38, R39, R41, R44, R47, R48, R50, R54, R57, R58, R60, R63, R66, R67, R69, R72, R75, R78, R81, R84, R87, R90, R93: 3K; R0805
R9, R11, R42, R51, R61, R70, R95, R96, R97, R98, R99, R100, R101, R102, R103, R104, R105, R106, R107, R108, R109, R110, R111, R112, R113, R114, R115, R116, R117, R118: 100K; R0402
R10, R12, R14, R16: 33R; R0805
R13, R18, R23: 1K; R0402
R20, R22, R24, R34, R36: 49R9; R0805
R26, R28: 330R; R0402
R52: 1M; R0402
R73, R76, R79, R82, R85, R88, R91, R94, R119, R120, R121, R122, R123, R124, R125, R126, R127, R128, R129, R130, R131, R132, R133, R134, R135, R136, R137, R138: 6.8K; R0402
RN1, RN2: 10K; 4X0402ARV341
S2: DTSM-3
U1: S9013; SOT-23-3; MPN MF-DSC-SOT233-MMBT5551
U2: W5500
U3, U4, U5, U6, U7, U8, U9, U10, U11, U12, U13, U14, U15, U16, U17, U18, U19, U20, U21, U22, U23, U24, U25, U26, U27, U28, U29, U30: NPN BJT S9013; SOT-23-3
U$1: CH340G; SOIC16
U$2: DC-DC-STEP-DOWN-MP1584
X1, X7, X8: TERMINAL-BLOCK-3.5MM-8-PIN-LONG-PAD; TERMINAL-BLOCK-8-PIN-3.5MM-LONG-PAD
X2: TERMINAL-BLOCK-3.5MM-9-PIN-LONG-PAD; TERMINAL-BLOCK-9-PIN-3.5MM-LONG-PAD
X4, X5: TERMINAL-BLOCK-3.5MM-4-PIN-LONG-PAD; TERMINAL-BLOCK-4-PIN-3.5MM-LONG-PAD

Connections:
5V_USB: C44.1, C45.2, CONN1.P1 (VUSB), U$1.16 (VCC)
+3V3: C1.1, C22.1, C24.1, C25.1, C26.1, C27.1, IC2.6 (VBAT), IC2.11 (VDD), IC2.22 (VDDA), IC2.28 (VDD), IC2.50 (VDD), IC2.75 (VDD), IC2.100 (VDD), J2.G+, J2.Y+, JP1.11, JP1.20, JP1.27, L1.2, Q2.2 (E), R4.1, R6.1, R8.1, R29.2, R31.2, RN1.6 (2), RN1.7 (2), RN1.8 (2), U2.28 (VDD), U$2.OUT+.1, U$2.OUT+.2
+3V3A: C3.1, C4.1, C5.1, C6.1, C15.1, C20.1, C23.1, L1.1, R20.2, R22.2, R24.2, U2.4 (AVDD), U2.8 (AVDD), U2.11 (AVDD), U2.15 (AVDD), U2.17 (AVDD), U2.21 (AVDD)
+24V: C7.1, C11.1, C30.1, C31.1, C32.1, C33.1, C34.1, C35.1, C36.1, C37.1, C38.1, C39.1, C40.1, C41.1, C42.1, C43.1, C49.1, C50.1, C51.1, C52.1, C53.1, C54.1, C55.1, C56.1, C57.1, C58.1, C59.1, C60.1, C61.1, C62.1, D1.C, D2.C, D3.C, D4.C, D5.C, D6.C, D7.C, D8.C, D9.C, D10.C, D11.C, D12.C, D13.C, D14.C, D15.C, D16.C, D17.C, D18.C, D19.C, D20.C, D21.C, D22.C, D23.C, D24.C, D25.A, D27.C, D28.C, D29.C, D30.C, F1.2A (2), OK1.4 (COL), OK2.4 (COL), OK3.4 (COL), OK4.4 (COL), OK5.4 (COL), OK6.4 (COL), OK7.4 (COL), OK8.4 (COL), OK9.4 (COL), OK10.4 (COL), OK11.4 (COL), OK12.4 (COL), OK13.4 (COL), OK14.4 (COL), OK15.4 (COL), OK16.4 (COL), OK17.4 (COL), OK18.4 (COL), OK19.4 (COL), OK20.4 (COL), OK21.4 (COL), OK22.4 (COL), OK23.4 (COL), OK24.4 (COL), OK25.4 (COL), OK26.4 (COL), OK27.4 (COL), OK28.4 (COL), R73.2, R76.2, R79.2, R82.2, R85.2, R88.2, R91.2, R94.2, R119.2, R120.2, R121.2, R122.2, R123.2, R124.2, R125.2, R126.2, R127.2, R128.2, R129.2, R130.2, R131.2, R132.2, R133.2, R134.2, R135.2, R136.2, R137.2, R138.2, X2.1, X2.2, X2.3, X2.4, X2.5, X2.6, X2.7, X2.8, X2.9, X4.1, X4.2, X4.3, X4.4
ACTLED: R26.1, U2.27 (ACTLED)
BOOT0: IC2.94 (BOOT0), JP1.33, R9.1, R23.1
BOOT1: IC2.37 (PB2), JP1.34, R11.1
CH340_D+: CONN1.P3 (D+), U$1.5 (D+)
CH340_D-: CONN1.P2 (D-), U$1.6 (D-)
I2C1_SCL: IC2.92 (PB6), JP1.29
I2C1_SDA: IC2.93 (PB7), JP1.31
I2C1_SMBA: IC2.91 (PB5), JP1.32
INTN: R6.2, U2.36 (INT_N)
LINKLED: R28.1, U2.25 (LINKLED)
unnamed: OK1.2 (C), R5.2
unnamed: LED1.C, R2.1
unnamed: C2.1, Q3.2, R3.1
unnamed: C17.1, IC2.8 (PC14), Q4.2
unnamed: D25.C, U$2.IN+.1, U$2.IN+.2
unnamed: C21.1, IC2.9 (PC15), Q4.1
unnamed: C29.1, IC2.12 (OSC_IN), Q3.1
unnamed: IC2.13 (OSC_OUT), R3.2
unnamed: OK1.3 (EMIT), R7.1
unnamed: R7.2, U1.P$1 (BASE)
unnamed: LED2.A, R76.1
unnamed: LED19.A, R73.1
unnamed: OK25.3 (EMIT), R39.1
unnamed: OK2.3 (EMIT), R17.1
unnamed: R17.2, U3.P$1 (BASE)
unnamed: OK2.2 (C), R15.2
unnamed: RN2.4 (1), U2.38 (RSVD)
unnamed: R18.2, U26.P$2 (EMITTER), U$1.14 (RTS)
unnamed: OK3.3 (EMIT), R21.1
unnamed: R21.2, U4.P$1 (BASE)
unnamed: OK3.2 (C), R19.2
unnamed: F1.1A (1), J1.2, J3.PWR
unnamed: OK4.3 (EMIT), R27.1
unnamed: R27.2, U5.P$1 (BASE)
unnamed: OK4.2 (C), R25.2
unnamed: C47.1, Q5.3 (2), U$1.7 (XI)
unnamed: OK5.3 (EMIT), R33.1
unnamed: R33.2, U6.P$1 (BASE)
unnamed: OK5.2 (C), R32.2
unnamed: C46.2, U$1.4 (V3)
unnamed: OK6.3 (EMIT), R38.1
unnamed: R38.2, U7.P$1 (BASE)
unnamed: OK6.2 (C), R37.2
unnamed: R13.2, U$1.13 (DTR)
unnamed: OK7.3 (EMIT), R41.1
unnamed: R41.2, U8.P$1 (BASE)
unnamed: OK7.2 (C), R40.2
unnamed: C48.1, Q5.1, U$1.8 (XO)
unnamed: OK8.3 (EMIT), R44.1
unnamed: R44.2, U9.P$1 (BASE)
unnamed: OK8.2 (C), R43.2
unnamed: R13.1, U26.P$1 (BASE)
unnamed: OK9.3 (EMIT), R47.1
unnamed: R47.2, U10.P$1 (BASE)
unnamed: OK9.2 (C), R46.2
unnamed: RN2.3 (1), U2.39 (RSVD)
unnamed: Q2.1 (B), R18.1
unnamed: RN2.2 (1), U2.40 (RSVD)
unnamed: OK10.3 (EMIT), R50.1
unnamed: RN2.1, U2.41 (RSVD)
unnamed: R50.2, U11.P$1 (BASE)
unnamed: RN1.4 (1), U2.42 (RSVD)
unnamed: OK10.2 (C), R49.2
unnamed: Q2.3 (C), R23.2
unnamed: OK11.3 (EMIT), R54.1
unnamed: R54.2, U12.P$1 (BASE)
unnamed: OK11.2 (C), R53.2
unnamed: D26.C, R29.1, U26.P$3 (COLLECTOR)
unnamed: OK12.3 (EMIT), R57.1
unnamed: R57.2, U13.P$1 (BASE)
unnamed: OK12.2 (C), R56.2
unnamed: R39.2, U27.P$1 (BASE)
unnamed: OK13.3 (EMIT), R60.1
unnamed: R60.2, U14.P$1 (BASE)
unnamed: OK13.2 (C), R59.2
unnamed: OK14.3 (EMIT), R63.1
unnamed: R63.2, U15.P$1 (BASE)
unnamed: OK14.2 (C), R62.2
unnamed: J2.Y-, R26.2
unnamed: OK25.2 (C), R35.2
unnamed: OK15.3 (EMIT), R66.1
unnamed: R66.2, U16.P$1 (BASE)
unnamed: OK15.2 (C), R65.2
unnamed: OK26.3 (EMIT), R48.1
unnamed: OK16.3 (EMIT), R69.1
unnamed: R69.2, U17.P$1 (BASE)
unnamed: OK16.2 (C), R68.2
unnamed: R48.2, U28.P$1 (BASE)
unnamed: OK17.3 (EMIT), R72.1
unnamed: J2.G-, R28.2
unnamed: R72.2, U18.P$1 (BASE)
unnamed: R1.1, R30.2
unnamed: OK17.2 (C), R71.2
unnamed: OK18.3 (EMIT), R75.1
unnamed: R75.2, U19.P$1 (BASE)
unnamed: OK18.2 (C), R74.2
unnamed: OK26.2 (C), R45.2
unnamed: OK19.3 (EMIT), R78.1
unnamed: R78.2, U20.P$1 (BASE)
unnamed: OK19.2 (C), R77.2
unnamed: OK27.3 (EMIT), R58.1
unnamed: OK20.3 (EMIT), R81.1
unnamed: R81.2, U21.P$1 (BASE)
unnamed: OK20.2 (C), R80.2
unnamed: R58.2, U29.P$1 (BASE)
unnamed: OK21.3 (EMIT), R84.1
unnamed: R84.2, U22.P$1 (BASE)
unnamed: OK21.2 (C), R83.2
unnamed: OK22.3 (EMIT), R87.1
unnamed: R87.2, U23.P$1 (BASE)
unnamed: OK22.2 (C), R86.2
unnamed: OK27.2 (C), R55.2
unnamed: OK23.3 (EMIT), R90.1
unnamed: R90.2, U24.P$1 (BASE)
unnamed: OK23.2 (C), R89.2
unnamed: OK28.3 (EMIT), R67.1
unnamed: OK24.3 (EMIT), R93.1
unnamed: R93.2, U25.P$1 (BASE)
unnamed: OK24.2 (C), R92.2
unnamed: R67.2, U30.P$1 (BASE)
unnamed: OK28.2 (C), R64.2
unnamed: D1.A, LED19.C, U1.P$3 (COLLECTOR), X1.1
unnamed: D2.A, LED2.C, U3.P$3 (COLLECTOR), X1.2
unnamed: LED3.A, R79.1
unnamed: D3.A, LED3.C, U4.P$3 (COLLECTOR), X1.3
unnamed: LED4.A, R82.1
unnamed: D4.A, LED4.C, U5.P$3 (COLLECTOR), X1.4
unnamed: LED5.A, R85.1
unnamed: D5.A, LED5.C, U6.P$3 (COLLECTOR), X1.5
unnamed: LED6.A, R88.1
unnamed: D6.A, LED6.C, U7.P$3 (COLLECTOR), X1.6
unnamed: LED7.A, R91.1
unnamed: D7.A, LED7.C, U8.P$3 (COLLECTOR), X1.7
unnamed: LED8.A, R94.1
unnamed: D8.A, LED8.C, U9.P$3 (COLLECTOR), X1.8
unnamed: LED9.A, R119.1
unnamed: D9.A, LED9.C, U10.P$3 (COLLECTOR), X7.1
unnamed: LED10.A, R120.1
unnamed: D10.A, LED10.C, U11.P$3 (COLLECTOR), X7.2
unnamed: LED11.A, R121.1
unnamed: D11.A, LED11.C, U12.P$3 (COLLECTOR), X7.3
unnamed: LED12.A, R122.1
unnamed: D12.A, LED12.C, U13.P$3 (COLLECTOR), X7.4
unnamed: LED13.A, R123.1
unnamed: D13.A, LED13.C, U14.P$3 (COLLECTOR), X7.5
unnamed: LED14.A, R124.1
unnamed: D14.A, LED14.C, U15.P$3 (COLLECTOR), X7.6
unnamed: LED15.A, R125.1
unnamed: D15.A, LED15.C, U16.P$3 (COLLECTOR), X7.7
unnamed: LED16.A, R126.1
unnamed: D16.A, LED16.C, U17.P$3 (COLLECTOR), X7.8
unnamed: LED17.A, R127.1
unnamed: D17.A, LED17.C, U18.P$3 (COLLECTOR), X8.1
unnamed: LED18.A, R128.1
unnamed: D18.A, LED18.C, U19.P$3 (COLLECTOR), X8.2
unnamed: LED20.A, R129.1
unnamed: D19.A, LED20.C, U20.P$3 (COLLECTOR), X8.3
unnamed: LED21.A, R130.1
unnamed: D20.A, LED21.C, U21.P$3 (COLLECTOR), X8.4
unnamed: LED22.A, R131.1
unnamed: D21.A, LED22.C, U22.P$3 (COLLECTOR), X8.5
unnamed: LED23.A, R132.1
unnamed: D22.A, LED23.C, U23.P$3 (COLLECTOR), X8.6
unnamed: LED24.A, R133.1
unnamed: D23.A, LED24.C, U24.P$3 (COLLECTOR), X8.7
unnamed: LED25.A, R134.1
unnamed: D24.A, LED25.C, U25.P$3 (COLLECTOR), X8.8
unnamed: LED26.A, R135.1
unnamed: D27.A, LED26.C, U27.P$3 (COLLECTOR), X5.1
unnamed: LED27.A, R136.1
unnamed: D28.A, LED27.C, U28.P$3 (COLLECTOR), X5.2
unnamed: LED28.A, R137.1
unnamed: D29.A, LED28.C, U29.P$3 (COLLECTOR), X5.3
unnamed: LED29.A, R138.1
unnamed: D30.A, LED29.C, U30.P$3 (COLLECTOR), X5.4
unnamed: RN1.3 (1), U2.43 (PMODE2)
unnamed: RN1.2 (1), U2.44 (PMODE1)
unnamed: RN1.1, U2.45 (PMODE0)
unnamed: C10.1, U2.20 (TOCAP)
unnamed: C9.1, U2.22 (1V2O)
unnamed: R30.1, U2.10 (EXRES1)
unnamed: C18.1, Q1.1, R52.2, U2.31 (XO)
unnamed: R14.1, U2.6 (RXP)
unnamed: R16.1, U2.5 (RXN)
unnamed: R10.1, U2.2 (TXP)
unnamed: R12.1, U2.1 (TXN)
unnamed: C19.1, Q1.3 (2), R52.1, U2.30 (XI/CLKIN)
PA0: IC2.23 (PA0-WKUP), OK1.1 (A), R95.1
PA1: IC2.24 (PA1), OK2.1 (A), R96.1
PA2: IC2.25 (PA2), OK3.1 (A), R97.1
PA3: IC2.26 (PA3), OK4.1 (A), R98.1
PA13: IC2.72 (PA13)
PA14: IC2.76 (PA14)
PA15: IC2.77 (PA15), OK14.1 (A), R108.1
PB0: IC2.35 (PB0), OK6.1 (A), R100.1
PB1: IC2.36 (PB1), OK7.1 (A), R101.1
PB3: IC2.89 (PB3), OK13.1 (A), R107.1
PB4: IC2.90 (PB4), OK12.1 (A), R106.1
PB8: IC2.95 (PB8), OK28.1 (A), R70.1
PB9: IC2.96 (PB9), OK5.1 (A), R99.1
PB10: IC2.47 (PB10), OK15.1 (A), R109.1
PB11: IC2.48 (PB11), OK16.1 (A), R110.1
PC0: IC2.15 (PC0)
PC1: IC2.16 (PC1)
PC2: IC2.17 (PC2)
PC3: IC2.18 (PC3)
PC4: IC2.33 (PC4)
PC5: IC2.34 (PC5)
PC6: IC2.63 (PC6), OK21.1 (A), R115.1
PC7: IC2.64 (PC7), OK22.1 (A), R116.1
PC8: IC2.65 (PC8), OK23.1 (A), R117.1
PC9: IC2.66 (PC9), OK24.1 (A), R118.1
PC13: IC2.7 (PC13), LED1.A
PD0: IC2.81 (PD0)
PD1: IC2.82 (PD1)
PD8: IC2.55 (PD8)
PD9: IC2.56 (PD9)
PD10: IC2.57 (PD10)
PD11: IC2.58 (PD11)
PD12: IC2.59 (PD12), OK17.1 (A), R111.1
PD13: IC2.60 (PD13), OK18.1 (A), R112.1
PD14: IC2.61 (PD14), OK19.1 (A), R113.1
PD15: IC2.62 (PD15), OK20.1 (A), R114.1
PE0: IC2.97 (PE0)
PE1: IC2.98 (PE1)
PE2: IC2.1 (PE2)
PE3: IC2.2 (PE3)
PE4: IC2.3 (PE4)
PE5: IC2.4 (PE5)
PE6: IC2.5 (PE6)
PE7: IC2.38 (PE7)
PE8: IC2.39 (PE8), OK8.1 (A), R102.1
PE9: IC2.40 (PE9), OK9.1 (A), R103.1
PE10: IC2.41 (PE10), OK10.1 (A), R104.1
PE11: IC2.42 (PE11), OK11.1 (A), R105.1
PE12: IC2.43 (PE12), OK25.1 (A), R42.1
PE13: IC2.44 (PE13), OK26.1 (A), R51.1
PE14: IC2.45 (PE14), OK27.1 (A), R61.1
PE15: IC2.46 (PE15)
R-CT: C13.2, J2.P5, R34.1, R36.1
RD+: C16.2, J2.RD+
RD-: C12.2, J2.RD-
RESET#: C28.1, D26.A, IC2.14 (NRST), R31.1, S2.2
RSTN: C8.1, R8.2, U2.37 (RST_N)
RXN: C12.1, R16.2, R36.2
RXP: C16.1, R14.2, R34.2
SPI1_MISO: IC2.31 (PA6), JP1.22, U2.34 (MISO)
SPI1_MOSI: IC2.32 (PA7), JP1.24, U2.35 (MOSI)
SPI1_NSS: IC2.29 (PA4), JP1.28, R4.2, U2.32 (SCS_N)
SPI1_SCK: IC2.30 (PA5), JP1.26, U2.33 (SCLK)
SPI2_MISO: IC2.53 (PB14), JP1.12
SPI2_MOSI: IC2.54 (PB15), JP1.14
SPI2_NSS: IC2.51 (PB12), JP1.18
SPI2_SCK: IC2.52 (PB13), JP1.16
T-CT: C14.2, J2.P4, R24.1
TXN: J2.TD-, R12.2, R20.1
TXP: J2.TD+, R10.2, R22.1
UART4_RX: IC2.78 (PC10), JP1.4
UART4_TX: IC2.79 (PC11), JP1.2
UART5_RX: IC2.80 (PC12), JP1.8
UART5_TX: IC2.83 (PD2), JP1.6
USART1_CK: IC2.67 (PA8), JP1.9
USART1_CTS: IC2.70 (PA11), JP1.1
USART1_RTS: IC2.71 (PA12), JP1.3
USART1_RX: IC2.68 (PA9), JP1.7, U$1.3 (RX)
USART1_TX: IC2.69 (PA10), JP1.5, U$1.2 (TX)
USART2_CK: IC2.88 (PD7), JP1.23
USART2_CTS: IC2.84 (PD3), JP1.15
USART2_RTS: IC2.85 (PD4), JP1.17
USART2_RX: IC2.86 (PD5), JP1.21
USART2_TX: IC2.87 (PD6), JP1.19
V-: C1.2, C2.2, C3.2, C4.2, C5.2, C6.2, C7.2, C8.2, C9.2, C10.2, C11.2, C13.1, C14.1, C15.2, C17.2, C18.2, C19.2, C20.2, C21.2, C22.2, C23.2, C24.2, C25.2, C26.2, C27.2, C28.2, C29.2, C30.2, C31.2, C32.2, C33.2, C34.2, C35.2, C36.2, C37.2, C38.2, C39.2, C40.2, C41.2, C42.2, C43.2, C44.2, C45.1, C46.1, C47.2, C48.2, C49.2, C50.2, C51.2, C52.2, C53.2, C54.2, C55.2, C56.2, C57.2, C58.2, C59.2, C60.2, C61.2, C62.2, CONN1.P5 (GND), IC2.10 (VSS), IC2.19 (VSSA), IC2.27 (VSS), IC2.49 (VSS), IC2.74 (VSS), IC2.99 (VSS), J1.1, J2.GND, J2.SHIELD0, J2.SHIELD1, J3.GND, J3.GNDBREAK, JP1.10, JP1.13, JP1.25, JP1.30, Q1.2, Q1.4, Q5.2, Q5.4, R1.2, R2.2, R5.1, R9.2, R11.2, R15.1, R19.1, R25.1, R32.1, R35.1, R37.1, R40.1, R42.2, R43.1, R45.1, R46.1, R49.1, R51.2, R53.1, R55.1, R56.1, R59.1, R61.2, R62.1, R64.1, R65.1, R68.1, R70.2, R71.1, R74.1, R77.1, R80.1, R83.1, R86.1, R89.1, R92.1, R95.2, R96.2, R97.2, R98.2, R99.2, R100.2, R101.2, R102.2, R103.2, R104.2, R105.2, R106.2, R107.2, R108.2, R109.2, R110.2, R111.2, R112.2, R113.2, R114.2, R115.2, R116.2, R117.2, R118.2, RN1.5 (2), RN2.5 (2), RN2.6 (2), RN2.7 (2), RN2.8 (2), S2.1, U1.P$2 (EMITTER), U2.3 (AGND), U2.9 (AGND), U2.14 (AGND), U2.16 (AGND), U2.19 (AGND), U2.29 (GND), U2.48 (AGND), U3.P$2 (EMITTER), U4.P$2 (EMITTER), U5.P$2 (EMITTER), U6.P$2 (EMITTER), U7.P$2 (EMITTER), U8.P$2 (EMITTER), U9.P$2 (EMITTER), U10.P$2 (EMITTER), U11.P$2 (EMITTER), U12.P$2 (EMITTER), U13.P$2 (EMITTER), U14.P$2 (EMITTER), U15.P$2 (EMITTER), U16.P$2 (EMITTER), U17.P$2 (EMITTER), U18.P$2 (EMITTER), U19.P$2 (EMITTER), U20.P$2 (EMITTER), U21.P$2 (EMITTER), U22.P$2 (EMITTER), U23.P$2 (EMITTER), U24.P$2 (EMITTER), U25.P$2 (EMITTER), U27.P$2 (EMITTER), U28.P$2 (EMITTER), U29.P$2 (EMITTER), U30.P$2 (EMITTER), U$1.1 (GND), U$2.IN-.1, U$2.IN-.2, U$2.OUT-.1, U$2.OUT-.2
VREF+: IC2.21 (VREF+)
VREF-: IC2.20 (VREF-)

Notes on the sheet:
DC - DC converter (set to 3.3V)
24V DC input
PERIPHERALS
RESET switch
Signalling LED
MCU
Ethernet
Filtering
Sortie alimentation bobines relais (+)
24x sorties commande relais (-)
USB -SERIAL Flash

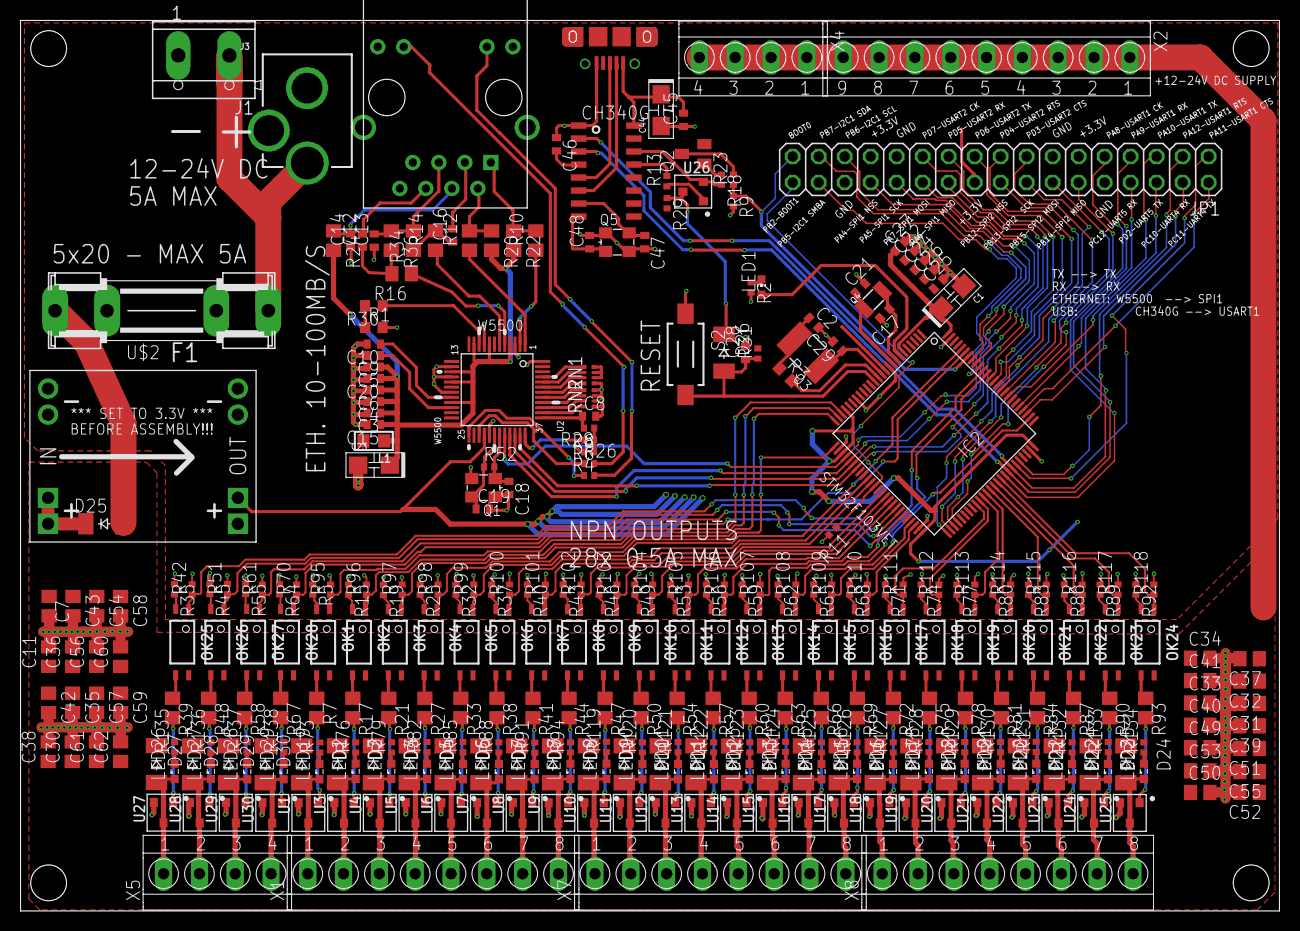
[picture p13: board STM32 output card.brd from above]

Board: 2 copper layers, 123.0 x 87.0 mm, 341 parts (0 on the bottom side), 253 nets.
