bdevijve/STM32F1_28Outputs/SW/STM32F1_28Outputs_SYNC/STM32F1_28Outputs_SYNC.ino

#define SERIALDEBUG1    // Comment to remove serial debugging info level 1
//#define SERIALDEBUG2    // Comment to remove serial debugging info level 2
//#define SERIALDEBUG9    // Comment to remove serial debugging info level 9
#define SELF_TEST       // teste toutes les sorties au démarrage
#define KEEP_BUG        // ne corrige pas le bug des channels 29 et +

/*
 * Reste à faire :  - Faire flasher Output[0] chaque seconde pendant la boucle loop si tout est OK                DONE
 *                  - HTTP Publish Output                                                                         DONE
 *                  - Watchdog (4s)                                                                               DONE
 *                  - HTTP Publish Uptime                                                                         DONE
 *                  - HTTP Publish FreeMemory                                                                     DONE
 *                  - Mettre tous les GPIO en INPUT_PULLDOWN à l’initialisation                                   DONE
 *                  - Nettoyage profond de la fonction d'accès à l'EEPROM et de la structure Settings             DONE
 *                  - Découpage en code plus court                                                                DONE
 *                  - HTTP set Output                                                                             DONE
 *                  - MQTT Publish Uptime                                                                         DONE
 *                  - MQTT Publish FreeMemory                                                                     DONE
 *                  
 *                  - Découverte que le serveur HTTP est bloquant...                  
 *                    il faut passer à https://github.com/philbowles/STM32AsyncWebServer
 *                  - Découverte que la partie MQTT freeze quand on redémarre le serveur MQTT...
 *                    il faut passer à https://github.com/philbowles/PangolinMQTT
 *                    
 *                  - Vérifier persistance des sorties après reboot (MQTT persistance sur le "[channel]/status")  
 *                  - Faire flasher Output[0] rapidement tant que l'init n'est pas terminé
 *                      et la connection MQTT établie
 *                  - DHCP Hostname & Freebox issue             
 *                  - Activer/désactiver la gestion du HTTP "POST" depuis une commande MQTT
 *                      (défault = possible si MQTT offline bien sûr)
 *                  - Vérifier memory leak sur 1 semaine avec des scripts MQTT et HTTP en //
 *
 */

#include <Ethernet.h>

#include <EEPROM.h>
#include <PubSubClient.h>     // Library from https://github.com/knolleary/pubsubclient (Standard on the Arduino IDE Library Manager)
#include <ArduinoUniqueID.h>  // Library from https://github.com/ricaun/ArduinoUniqueID (Standard on the Arduino IDE Library Manager)
#include <IWatchdog.h>        // Library included in Arduino_Core_STM32 version > 1.3.0

bool IWatchdog_isReset=false;
long BlinkStatus = 0;                            // Use to make Blink Status LED once each second

byte mac[] = {0x00, 0x80, 0xE1, 0x03, 0x04, 0x05} ; 

#define ETH_CS_PIN PA4
#define STATUS_PIN PC13

EthernetServer HTTPEthernetServer(80);
EthernetClient MqttEthernetClient;
PubSubClient mqttClient (MqttEthernetClient);

bool needReset = false;

long MQTT_LastReconnectAttempt = 0;                 // For automatic reconnection, non-blocking
long MQTT_LastUptimeSent = 0;                       // For sending MQTT Uptime every nn seconds
long LoopIterationCount = 0;                        // For counting loop runs in the nn seconds timeframe
long ActionCount = 0;                               // For counting total action

#include "Tools.h"
#include "MQTT.h"
#include "HTTP.h"

void setup() {
  
  { // initialize ALL GPIO pins to INPUT_PULLDOWN in order to limit interrupts on floating pins
    int pinNumber = 0;
    while ( GPIOINIT_TABLE[pinNumber] != 0xffff ) pinMode(GPIOINIT_TABLE[pinNumber++], INPUT_PULLDOWN);
  }
  
  Serial.begin(115200);
  IWatchdog_isReset=IWatchdog.isReset(true);

  if ( IWatchdog_isReset ) Serial.println("Card was restarted by Watchdog !!");

  #ifdef SERIALDEBUG1
    { long now = millis();Serial.print(now); }
    Serial.println(" - Begin of SETUP !!!");
    Serial.print("UniqueID  - ");UniqueIDdump(Serial);
    Serial.print("UniqueID8 - ");UniqueID8dump(Serial);
  #endif


  // initialize output pins
  for (int pinNumber = 0; pinNumber < OUTPUT_COUNT+1; pinNumber++) {
    pinMode(GPIO_OUTPUT[pinNumber], OUTPUT);
    digitalWrite(GPIO_OUTPUT[pinNumber], LOW);
	}


  #ifdef SELF_TEST
    for (int i=0; i<OUTPUT_COUNT+1 ; i++){ digitalWrite(GPIO_OUTPUT[i], 1);delay(10);digitalWrite(GPIO_OUTPUT[i], 0); }
    for (int i=OUTPUT_COUNT; i>=0; i--)  { digitalWrite(GPIO_OUTPUT[i], 1);delay(10);digitalWrite(GPIO_OUTPUT[i], 0); }
  #endif


//// MAKE BLINK FAST HERE
  
  mac[0] = 0x00; // UniqueID8[2]; 
  mac[1] = 0x80; // UniqueID8[3]; 
  mac[2] = 0xE1; // UniqueID8[4]; 
  mac[3] = UniqueID8[5]; 
  mac[4] = UniqueID8[6]; 
  mac[5] = UniqueID8[7]; 

  #ifdef SERIALDEBUG1
    Serial.print("MAC :");
    for (byte octet = 0; octet < 6; octet++) {
      Serial.print(mac[octet], HEX);
      if (octet < 5) Serial.print('-');
      }
    Serial.println();
  #endif

  for(size_t i = 0; i < 8; i++)
	  MQTT_CLIENT_ID[i] = UniqueID8[i]; 
  MQTT_CLIENT_ID[8] = 0;
  
	#ifdef SERIALDEBUG1
    Serial.print("MQTT CLIENT ID:");
    Serial.println(MQTT_CLIENT_ID);
  #endif
  
  for (int i= 0 ; i<8 ; i++){
	  if ( ((uint8_t)MQTT_CLIENT_ID[i] < 48) || ((uint8_t)MQTT_CLIENT_ID[i] > 122) || ( (uint8_t)MQTT_CLIENT_ID[i]>90 && (uint8_t)MQTT_CLIENT_ID[i]<97) || ( (uint8_t)MQTT_CLIENT_ID[i]>57 && (uint8_t)MQTT_CLIENT_ID[i]<65)){
		  #ifdef SERIALDEBUG1
  		  Serial.print("Caractère interdit, remplacé par un A: ");
  		  Serial.println(MQTT_CLIENT_ID[i]);
		  #endif
		  MQTT_CLIENT_ID[i]= 'A';
	    }	  
    }
  #ifdef SERIALDEBUG1
    Serial.print("MQTT CLIENT ID:");
    Serial.println(MQTT_CLIENT_ID);
  #endif
  
  readStoredVariables();
  
  #ifdef SERIALDEBUG1
    { long now = millis(); Serial.print(now); }
    Serial.println (" - Lecture EEPROM:");
    Serial.println(settings.deviceName);
    Serial.print(settings.mqttServerIP[0]);Serial.print(".");
    Serial.print(settings.mqttServerIP[1]);Serial.print(".");
    Serial.print(settings.mqttServerIP[2]);Serial.print(".");
    Serial.println(settings.mqttServerIP[3]);
    Serial.println(settings.mqttPrefix);    
    Serial.println(settings.subTopicStatus);
    Serial.println(settings.subTopicSet);
    Serial.println(settings.subTopicDebug);
  #endif
  
  #ifdef SERIALDEBUG1
    { long now = millis(); Serial.print(now); }
    Serial.println(" - Ethernet Initialisation...") ;
	#endif
	
  
  Ethernet.init(ETH_CS_PIN);  // Start the Ethernet connection and the server
  //  Ethernet.hostName(settings.deviceName);
  Ethernet.begin(mac);

  // Check for Ethernet hardware present
  if (Ethernet.hardwareStatus() == EthernetNoHardware) {
    while (true) {
      Serial.println("Ethernet shield was not found.  Sorry, can't run without hardware. :(");
      delay(1000); // do nothing, no point running without Ethernet hardware
      }
    }
  if (Ethernet.linkStatus() == LinkOFF) Serial.println("Ethernet cable is not connected.");

  
  HTTPEthernetServer.begin(); // Start the HTTP Server
  #ifdef SERIALDEBUG1
    { long now = millis(); Serial.print(now); }
    Serial.print(" - My IP Address is ");
    Serial.println(Ethernet.localIP());
  #endif
  
 	#ifdef SERIALDEBUG1
    { long now = millis(); Serial.print(now); }
    Serial.println(" - Initialisation MQTT... ") ;
	#endif

	
   // -- Prepare dynamic topic name with trailing slash
   	
	strcpy (dynamicTopic, settings.mqttPrefix);
	strcat (dynamicTopic, "/");
	strcat (dynamicTopic, settings.deviceName);
	strcat (dynamicTopic, "/");
	
	mqttClient.setServer(settings.mqttServerIP, MQTT_PORT) ;
	mqttClient.setCallback(mqttCallback) ;
	
	MQTT_LastReconnectAttempt = 0;

  IWatchdog.begin(4000000);
  #ifdef SERIALDEBUG1
    { long now = millis(); Serial.print(now); }
    Serial.println(" - Watchdog set to 4s");
  #endif

  
	#ifdef SERIALDEBUG1
	  { long now = millis(); Serial.print(now); }
	  Serial.println(" - End of SETUP");
  #endif
}

void loop() {
	IWatchdog.reload(); // Recharge le watchdog !!
	if (needReset){
    long now = millis();Serial.print(now);
		Serial.println(" - Rebooting...");
    delay(200);NVIC_SystemReset();
	}
  
	if (!mqttClient.connected()) {
    long now = millis();
    if (now - MQTT_LastReconnectAttempt >= 1000) {
      MQTT_LastReconnectAttempt = now;
      // Attempt to reconnect
      #ifdef SERIALDEBUG1
        Serial.print(now);
	      Serial.println (" - MQTT connecting...");
	    #endif
	  
	  if (MQTT_Reconnect()) {
      #ifdef SERIALDEBUG1
		    Serial.print(now);
        Serial.println (" - MQTT connected !!");
		  #endif
		
		  MQTT_LastReconnectAttempt = 0;
      }
    }
  } else {
    // Client connected
    long now = millis();

    if (now - BlinkStatus >= 50) {
      if (now - BlinkStatus < 100) { digitalWrite(GPIO_OUTPUT[0], isON[0]); BlinkStatus-=51; }
      if (now - BlinkStatus >= 1050) { digitalWrite(GPIO_OUTPUT[0], !isON[0]); BlinkStatus = now; }
      }
    
    if (now - MQTT_LastUptimeSent >= 10000) {
      MQTT_LastUptimeSent = now; MQTT_SendDebug(); LoopIterationCount=0;
    } else LoopIterationCount++;
    mqttClient.loop();
  }


  // listen for incoming clients
  EthernetClient HTTPEthernetClient;

  HTTPEthernetClient = HTTPEthernetServer.available();
  if (HTTPEthernetClient) {  // got client?
    bool currentLineIsBlank = true;
		String req_str = "";
		int data_length = -1;
		bool skip = true;
		bool dataPresent = false ;
		
    while (HTTPEthernetClient.connected()) {
      if (HTTPEthernetClient.available()) {   // client data available to read
        char c = HTTPEthernetClient.read(); // read 1 byte (character) from client
				req_str += c; // store characters to string
				
				// last line of client request is blank and ends with \n
                // respond to client only after last line received
                if (c == '\n' && currentLineIsBlank && req_str.startsWith("GET")) {
					writeHTTPResponse(HTTPEthernetClient);
					break;
				}
				
				if (c == '\n' && currentLineIsBlank && req_str.startsWith("POST") && !skip) {
					writeHTTPResponse(HTTPEthernetClient);
					break;
				}   
				
				if (c == '\n' && currentLineIsBlank && req_str.startsWith("POST") && skip) {
					skip = false;
					dataPresent = true ;
					String temp = req_str.substring(req_str.indexOf("Content-Length:") + 15);
					temp.trim();
					data_length = temp.toInt();
					while(data_length-- > 0)
				  {
						c = HTTPEthernetClient.read();
						req_str += c;
					}

  if (dataPresent){
    dataPresent  = false ;

    #ifdef SERIALDEBUG2
      Serial.println("Chaîne HTTP REQ:"); Serial.println(req_str);
    #endif

    if (req_str.indexOf("deviceName=") > 0) handleHTTPPost_deviceName(req_str);
    else if (req_str.indexOf("switch_output=") > 0 ) handleHTTPPost_switch_output(req_str);
    }
          writeHTTPResponse(HTTPEthernetClient);
					break;
				}
		
                // every line of text received from the client ends with \r\n
                if (c == '\n') {
                    // last character on line of received text
                    // starting new line with next character read
                    currentLineIsBlank = true;
                }
                else if (c != '\r') {
                    // a text character was received from client
                    currentLineIsBlank = false;
                }
            } // end if (HTTPEthernetClient.available())
        } // end while (HTTPEthernetClient.connected())
		
    HTTPEthernetClient.stop(); // close the connection
	}
}
