bdevijve/STM32F1_28Outputs/SW/STM32F1_28Outputs_ASYNC-TEST/STM32F1_28Outputs_ASYNC-TEST/MyTools.h

void Init_WATCHDOG(void) {
  ;
} // ---------- END OF Init_WATCHDOG ----------

void Init_ALLGPIO_INPUTPULLDOWN(void) {
  ;
} // ---------- END OF Init_ALLGPIO_INPUT-PULLDOWN ----------

void Init_SERIALDEBUG(void) {
  ;
} // ---------- END OF Init_SERIAL-DEBUG ----------

void Init_GPIO_OUTPUT(void) {
  ;
} // ---------- END OF Init_GPIO_OUTPUT ----------

void Init_NETWORK(void) {
  ;
} // ---------- END OF Init_NETWORK ----------
