bdevijve/STM32F1_28Outputs/(notices)

Notices in the files:
parts and their libraries:
rc-master-smd: Copyright (C) 2007, Bob Starr
crystal-geyer_V1_0: Copyright: Geyer-Electronic
diy-modules: Released under the Creative Commons Attribution 4.0 International License: http://creativecommons.org/licenses/by/4.0
